beanz/typhon-scad/readme.md

# Typhon-scad
Cerberus-revised for MGN rails

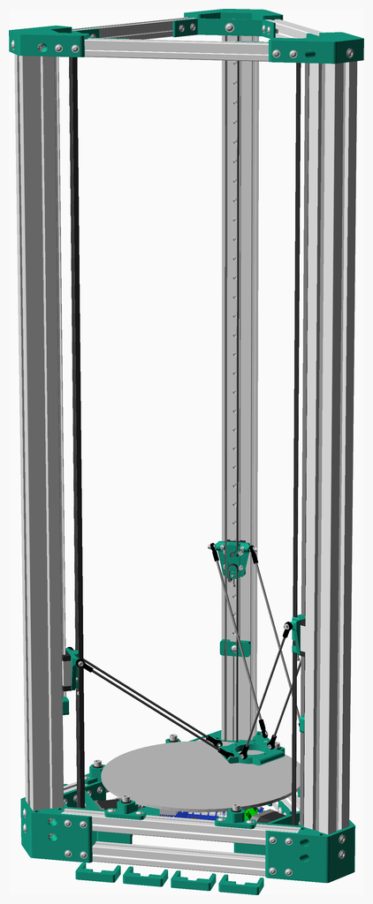
[picture p1: assemblies/main_assembled.png]
Main Assembly


<span></span>

---
## Table of Contents
1. [Parts list](#Parts_list)
1. [Duet Assembly](#duet_assembly)
1. [Effector Assembly](#effector_assembly)
1. [Idler Bearing Assembly](#idler_bearing_assembly)
1. [Idler Assembly](#idler_assembly)
1. [Top Corner Assembly](#top_corner_assembly)
1. [Bottom Motor Mount Assembly](#bottom_motor_mount_assembly)
1. [Bed Mount Right Assembly](#bed_mount_right_assembly)
1. [Bed Mount Left Assembly](#bed_mount_left_assembly)
1. [Bottom Extrusion Assembly](#bottom_extrusion_assembly)
1. [Bottom Corner Bottom Assembly](#bottom_corner_bottom_assembly)
1. [Two Part Bottom Corner Assembly](#two_part_bottom_corner_assembly)
1. [Bottom Corner Assembly](#bottom_corner_assembly)
1. [Arm Assembly](#arm_assembly)
1. [Carriage Assembly](#carriage_assembly)
1. [Rail Guard Assembly](#rail_guard_assembly)
1. [Upright C Assembly](#upright_c_assembly)
1. [Tower C Assembly](#tower_c_assembly)
1. [Upright B Assembly](#upright_b_assembly)
1. [Tower B Assembly](#tower_b_assembly)
1. [Upright A Assembly](#upright_a_assembly)
1. [Tower A Assembly](#tower_a_assembly)
1. [Main Assembly](#main_assembly)

<span></span>
[Top](#TOP)

---

## Parts list
| <span style="writing-mode: vertical-rl; text-orientation: mixed;">Duet</span> | <span style="writing-mode: vertical-rl; text-orientation: mixed;">Effector</span> | <span style="writing-mode: vertical-rl; text-orientation: mixed;">3 x Idler&nbsp;Bearing</span> | <span style="writing-mode: vertical-rl; text-orientation: mixed;">3 x Idler</span> | <span style="writing-mode: vertical-rl; text-orientation: mixed;">3 x Top&nbsp;Corner</span> | <span style="writing-mode: vertical-rl; text-orientation: mixed;">3 x Bottom&nbsp;Motor&nbsp;Mount</span> | <span style="writing-mode: vertical-rl; text-orientation: mixed;">3 x Bed&nbsp;Mount&nbsp;Right</span> | <span style="writing-mode: vertical-rl; text-orientation: mixed;">3 x Bed&nbsp;Mount&nbsp;Left</span> | <span style="writing-mode: vertical-rl; text-orientation: mixed;">3 x Bottom&nbsp;Extrusion</span> | <span style="writing-mode: vertical-rl; text-orientation: mixed;">3 x Bottom&nbsp;Corner&nbsp;Bottom</span> | <span style="writing-mode: vertical-rl; text-orientation: mixed;">3 x Two&nbsp;Part&nbsp;Bottom&nbsp;Corner</span> | <span style="writing-mode: vertical-rl; text-orientation: mixed;">3 x Bottom&nbsp;Corner</span> | <span style="writing-mode: vertical-rl; text-orientation: mixed;">3 x Arm</span> | <span style="writing-mode: vertical-rl; text-orientation: mixed;">3 x Carriage</span> | <span style="writing-mode: vertical-rl; text-orientation: mixed;">3 x Rail&nbsp;Guard</span> | <span style="writing-mode: vertical-rl; text-orientation: mixed;">Upright&nbsp;C</span> | <span style="writing-mode: vertical-rl; text-orientation: mixed;">Tower&nbsp;C</span> | <span style="writing-mode: vertical-rl; text-orientation: mixed;">Upright&nbsp;B</span> | <span style="writing-mode: vertical-rl; text-orientation: mixed;">Tower&nbsp;B</span> | <span style="writing-mode: vertical-rl; text-orientation: mixed;">Upright&nbsp;A</span> | <span style="writing-mode: vertical-rl; text-orientation: mixed;">Tower&nbsp;A</span> | <span style="writing-mode: vertical-rl; text-orientation: mixed;">Main</span> | <span style="writing-mode: vertical-rl; text-orientation: mixed;">TOTALS</span> |  |
|---:|---:|---:|---:|---:|---:|---:|---:|---:|---:|---:|---:|---:|---:|---:|---:|---:|---:|---:|---:|---:|---:|---:|:---|
|  |  |  |  |  |  |  |  |  |  |  |  |  |  |  |  |  |  |  |  |  |  | | **Vitamins** |
| &nbsp;&nbsp;.&nbsp; | &nbsp;&nbsp;.&nbsp; | &nbsp;&nbsp;6&nbsp; | &nbsp;&nbsp;.&nbsp; | &nbsp;&nbsp;.&nbsp; | &nbsp;&nbsp;.&nbsp; | &nbsp;&nbsp;.&nbsp; | &nbsp;&nbsp;.&nbsp; | &nbsp;&nbsp;.&nbsp; | &nbsp;&nbsp;.&nbsp; | &nbsp;&nbsp;.&nbsp; | &nbsp;&nbsp;.&nbsp; | &nbsp;&nbsp;.&nbsp; | &nbsp;&nbsp;.&nbsp; | &nbsp;&nbsp;.&nbsp; | &nbsp;&nbsp;.&nbsp; | &nbsp;&nbsp;.&nbsp; | &nbsp;&nbsp;.&nbsp; | &nbsp;&nbsp;.&nbsp; | &nbsp;&nbsp;.&nbsp; | &nbsp;&nbsp;.&nbsp; | &nbsp;&nbsp;.&nbsp; |  &nbsp;&nbsp;6&nbsp; | &nbsp;&nbsp; Ball bearing F625ZZ 5mm x 16mm x 5mm |
| &nbsp;&nbsp;.&nbsp; | &nbsp;&nbsp;.&nbsp; | &nbsp;&nbsp;.&nbsp; | &nbsp;&nbsp;.&nbsp; | &nbsp;&nbsp;.&nbsp; | &nbsp;&nbsp;.&nbsp; | &nbsp;&nbsp;.&nbsp; | &nbsp;&nbsp;.&nbsp; | &nbsp;&nbsp;.&nbsp; | &nbsp;&nbsp;.&nbsp; | &nbsp;&nbsp;.&nbsp; | &nbsp;&nbsp;.&nbsp; | &nbsp;&nbsp;.&nbsp; | &nbsp;&nbsp;.&nbsp; | &nbsp;&nbsp;.&nbsp; | &nbsp;&nbsp;.&nbsp; | &nbsp;&nbsp;1&nbsp; | &nbsp;&nbsp;.&nbsp; | &nbsp;&nbsp;.&nbsp; | &nbsp;&nbsp;.&nbsp; | &nbsp;&nbsp;.&nbsp; | &nbsp;&nbsp;.&nbsp; |  &nbsp;&nbsp;1&nbsp; | &nbsp;&nbsp; Belt GT2 x 6mm x 2072mm |
| &nbsp;&nbsp;.&nbsp; | &nbsp;&nbsp;.&nbsp; | &nbsp;&nbsp;.&nbsp; | &nbsp;&nbsp;.&nbsp; | &nbsp;&nbsp;.&nbsp; | &nbsp;&nbsp;.&nbsp; | &nbsp;&nbsp;.&nbsp; | &nbsp;&nbsp;.&nbsp; | &nbsp;&nbsp;.&nbsp; | &nbsp;&nbsp;.&nbsp; | &nbsp;&nbsp;.&nbsp; | &nbsp;&nbsp;.&nbsp; | &nbsp;&nbsp;.&nbsp; | &nbsp;&nbsp;.&nbsp; | &nbsp;&nbsp;.&nbsp; | &nbsp;&nbsp;.&nbsp; | &nbsp;&nbsp;.&nbsp; | &nbsp;&nbsp;.&nbsp; | &nbsp;&nbsp;1&nbsp; | &nbsp;&nbsp;.&nbsp; | &nbsp;&nbsp;.&nbsp; | &nbsp;&nbsp;.&nbsp; |  &nbsp;&nbsp;1&nbsp; | &nbsp;&nbsp; Belt GT2 x 6mm x 2072mm |
| &nbsp;&nbsp;.&nbsp; | &nbsp;&nbsp;.&nbsp; | &nbsp;&nbsp;.&nbsp; | &nbsp;&nbsp;.&nbsp; | &nbsp;&nbsp;.&nbsp; | &nbsp;&nbsp;.&nbsp; | &nbsp;&nbsp;.&nbsp; | &nbsp;&nbsp;.&nbsp; | &nbsp;&nbsp;.&nbsp; | &nbsp;&nbsp;.&nbsp; | &nbsp;&nbsp;.&nbsp; | &nbsp;&nbsp;.&nbsp; | &nbsp;&nbsp;.&nbsp; | &nbsp;&nbsp;.&nbsp; | &nbsp;&nbsp;.&nbsp; | &nbsp;&nbsp;.&nbsp; | &nbsp;&nbsp;.&nbsp; | &nbsp;&nbsp;.&nbsp; | &nbsp;&nbsp;.&nbsp; | &nbsp;&nbsp;.&nbsp; | &nbsp;&nbsp;1&nbsp; | &nbsp;&nbsp;.&nbsp; |  &nbsp;&nbsp;1&nbsp; | &nbsp;&nbsp; Belt GT2 x 6mm x 2072mm |
| &nbsp;&nbsp;.&nbsp; | &nbsp;&nbsp;.&nbsp; | &nbsp;&nbsp;.&nbsp; | &nbsp;&nbsp;.&nbsp; | &nbsp;&nbsp;.&nbsp; | &nbsp;&nbsp;.&nbsp; | &nbsp;&nbsp;.&nbsp; | &nbsp;&nbsp;.&nbsp; | &nbsp;&nbsp;.&nbsp; | &nbsp;&nbsp;.&nbsp; | &nbsp;&nbsp;.&nbsp; | &nbsp;&nbsp;.&nbsp; | &nbsp;&nbsp;6&nbsp; | &nbsp;&nbsp;.&nbsp; | &nbsp;&nbsp;.&nbsp; | &nbsp;&nbsp;.&nbsp; | &nbsp;&nbsp;.&nbsp; | &nbsp;&nbsp;.&nbsp; | &nbsp;&nbsp;.&nbsp; | &nbsp;&nbsp;.&nbsp; | &nbsp;&nbsp;.&nbsp; | &nbsp;&nbsp;.&nbsp; |  &nbsp;&nbsp;6&nbsp; | &nbsp;&nbsp; CF rod 3mm x 231mm |
| &nbsp;&nbsp;1&nbsp; | &nbsp;&nbsp;.&nbsp; | &nbsp;&nbsp;.&nbsp; | &nbsp;&nbsp;.&nbsp; | &nbsp;&nbsp;.&nbsp; | &nbsp;&nbsp;.&nbsp; | &nbsp;&nbsp;.&nbsp; | &nbsp;&nbsp;.&nbsp; | &nbsp;&nbsp;.&nbsp; | &nbsp;&nbsp;.&nbsp; | &nbsp;&nbsp;.&nbsp; | &nbsp;&nbsp;.&nbsp; | &nbsp;&nbsp;.&nbsp; | &nbsp;&nbsp;.&nbsp; | &nbsp;&nbsp;.&nbsp; | &nbsp;&nbsp;.&nbsp; | &nbsp;&nbsp;.&nbsp; | &nbsp;&nbsp;.&nbsp; | &nbsp;&nbsp;.&nbsp; | &nbsp;&nbsp;.&nbsp; | &nbsp;&nbsp;.&nbsp; | &nbsp;&nbsp;.&nbsp; |  &nbsp;&nbsp;1&nbsp; | &nbsp;&nbsp; Cat 5 patch cable 300mm |
| &nbsp;&nbsp;1&nbsp; | &nbsp;&nbsp;.&nbsp; | &nbsp;&nbsp;.&nbsp; | &nbsp;&nbsp;.&nbsp; | &nbsp;&nbsp;.&nbsp; | &nbsp;&nbsp;.&nbsp; | &nbsp;&nbsp;.&nbsp; | &nbsp;&nbsp;.&nbsp; | &nbsp;&nbsp;.&nbsp; | &nbsp;&nbsp;.&nbsp; | &nbsp;&nbsp;.&nbsp; | &nbsp;&nbsp;.&nbsp; | &nbsp;&nbsp;.&nbsp; | &nbsp;&nbsp;.&nbsp; | &nbsp;&nbsp;.&nbsp; | &nbsp;&nbsp;.&nbsp; | &nbsp;&nbsp;.&nbsp; | &nbsp;&nbsp;.&nbsp; | &nbsp;&nbsp;.&nbsp; | &nbsp;&nbsp;.&nbsp; | &nbsp;&nbsp;.&nbsp; | &nbsp;&nbsp;.&nbsp; |  &nbsp;&nbsp;1&nbsp; | &nbsp;&nbsp; Duet 2 Ethernet electronics |
| &nbsp;&nbsp;.&nbsp; | &nbsp;&nbsp;.&nbsp; | &nbsp;&nbsp;.&nbsp; | &nbsp;&nbsp;.&nbsp; | &nbsp;&nbsp;3&nbsp; | &nbsp;&nbsp;.&nbsp; | &nbsp;&nbsp;.&nbsp; | &nbsp;&nbsp;.&nbsp; | &nbsp;&nbsp;3&nbsp; | &nbsp;&nbsp;.&nbsp; | &nbsp;&nbsp;.&nbsp; | &nbsp;&nbsp;3&nbsp; | &nbsp;&nbsp;.&nbsp; | &nbsp;&nbsp;.&nbsp; | &nbsp;&nbsp;.&nbsp; | &nbsp;&nbsp;.&nbsp; | &nbsp;&nbsp;.&nbsp; | &nbsp;&nbsp;.&nbsp; | &nbsp;&nbsp;.&nbsp; | &nbsp;&nbsp;.&nbsp; | &nbsp;&nbsp;.&nbsp; | &nbsp;&nbsp;.&nbsp; |  &nbsp;&nbsp;9&nbsp; | &nbsp;&nbsp; Extrusion E2020 x 300mm |
| &nbsp;&nbsp;.&nbsp; | &nbsp;&nbsp;.&nbsp; | &nbsp;&nbsp;.&nbsp; | &nbsp;&nbsp;.&nbsp; | &nbsp;&nbsp;.&nbsp; | &nbsp;&nbsp;.&nbsp; | &nbsp;&nbsp;.&nbsp; | &nbsp;&nbsp;.&nbsp; | &nbsp;&nbsp;.&nbsp; | &nbsp;&nbsp;.&nbsp; | &nbsp;&nbsp;.&nbsp; | &nbsp;&nbsp;.&nbsp; | &nbsp;&nbsp;.&nbsp; | &nbsp;&nbsp;.&nbsp; | &nbsp;&nbsp;.&nbsp; | &nbsp;&nbsp;1&nbsp; | &nbsp;&nbsp;.&nbsp; | &nbsp;&nbsp;1&nbsp; | &nbsp;&nbsp;.&nbsp; | &nbsp;&nbsp;1&nbsp; | &nbsp;&nbsp;.&nbsp; | &nbsp;&nbsp;.&nbsp; |  &nbsp;&nbsp;3&nbsp; | &nbsp;&nbsp; Extrusion E4040 x 1000mm |
| &nbsp;&nbsp;.&nbsp; | &nbsp;&nbsp;.&nbsp; | &nbsp;&nbsp;.&nbsp; | &nbsp;&nbsp;.&nbsp; | &nbsp;&nbsp;.&nbsp; | &nbsp;&nbsp;.&nbsp; | &nbsp;&nbsp;.&nbsp; | &nbsp;&nbsp;.&nbsp; | &nbsp;&nbsp;.&nbsp; | &nbsp;&nbsp;24&nbsp; | &nbsp;&nbsp;.&nbsp; | &nbsp;&nbsp;.&nbsp; | &nbsp;&nbsp;.&nbsp; | &nbsp;&nbsp;.&nbsp; | &nbsp;&nbsp;.&nbsp; | &nbsp;&nbsp;.&nbsp; | &nbsp;&nbsp;.&nbsp; | &nbsp;&nbsp;.&nbsp; | &nbsp;&nbsp;.&nbsp; | &nbsp;&nbsp;.&nbsp; | &nbsp;&nbsp;.&nbsp; | &nbsp;&nbsp;.&nbsp; |  &nbsp;&nbsp;24&nbsp; | &nbsp;&nbsp; Heatfit insert M3 x 4mm |
| &nbsp;&nbsp;.&nbsp; | &nbsp;&nbsp;.&nbsp; | &nbsp;&nbsp;.&nbsp; | &nbsp;&nbsp;.&nbsp; | &nbsp;&nbsp;.&nbsp; | &nbsp;&nbsp;.&nbsp; | &nbsp;&nbsp;.&nbsp; | &nbsp;&nbsp;.&nbsp; | &nbsp;&nbsp;.&nbsp; | &nbsp;&nbsp;.&nbsp; | &nbsp;&nbsp;.&nbsp; | &nbsp;&nbsp;.&nbsp; | &nbsp;&nbsp;.&nbsp; | &nbsp;&nbsp;.&nbsp; | &nbsp;&nbsp;.&nbsp; | &nbsp;&nbsp;1&nbsp; | &nbsp;&nbsp;.&nbsp; | &nbsp;&nbsp;1&nbsp; | &nbsp;&nbsp;.&nbsp; | &nbsp;&nbsp;1&nbsp; | &nbsp;&nbsp;.&nbsp; | &nbsp;&nbsp;.&nbsp; |  &nbsp;&nbsp;3&nbsp; | &nbsp;&nbsp; Linear rail MGN12 x 800mm |
| &nbsp;&nbsp;.&nbsp; | &nbsp;&nbsp;.&nbsp; | &nbsp;&nbsp;.&nbsp; | &nbsp;&nbsp;.&nbsp; | &nbsp;&nbsp;.&nbsp; | &nbsp;&nbsp;.&nbsp; | &nbsp;&nbsp;.&nbsp; | &nbsp;&nbsp;.&nbsp; | &nbsp;&nbsp;.&nbsp; | &nbsp;&nbsp;.&nbsp; | &nbsp;&nbsp;.&nbsp; | &nbsp;&nbsp;.&nbsp; | &nbsp;&nbsp;.&nbsp; | &nbsp;&nbsp;3&nbsp; | &nbsp;&nbsp;.&nbsp; | &nbsp;&nbsp;.&nbsp; | &nbsp;&nbsp;.&nbsp; | &nbsp;&nbsp;.&nbsp; | &nbsp;&nbsp;.&nbsp; | &nbsp;&nbsp;.&nbsp; | &nbsp;&nbsp;.&nbsp; | &nbsp;&nbsp;.&nbsp; |  &nbsp;&nbsp;3&nbsp; | &nbsp;&nbsp; Linear rail carriage MGN12H |
| &nbsp;&nbsp;1&nbsp; | &nbsp;&nbsp;.&nbsp; | &nbsp;&nbsp;.&nbsp; | &nbsp;&nbsp;.&nbsp; | &nbsp;&nbsp;.&nbsp; | &nbsp;&nbsp;.&nbsp; | &nbsp;&nbsp;.&nbsp; | &nbsp;&nbsp;.&nbsp; | &nbsp;&nbsp;.&nbsp; | &nbsp;&nbsp;.&nbsp; | &nbsp;&nbsp;.&nbsp; | &nbsp;&nbsp;.&nbsp; | &nbsp;&nbsp;.&nbsp; | &nbsp;&nbsp;.&nbsp; | &nbsp;&nbsp;.&nbsp; | &nbsp;&nbsp;.&nbsp; | &nbsp;&nbsp;.&nbsp; | &nbsp;&nbsp;.&nbsp; | &nbsp;&nbsp;.&nbsp; | &nbsp;&nbsp;.&nbsp; | &nbsp;&nbsp;.&nbsp; | &nbsp;&nbsp;.&nbsp; |  &nbsp;&nbsp;1&nbsp; | &nbsp;&nbsp; Micro SD card |
| &nbsp;&nbsp;.&nbsp; | &nbsp;&nbsp;.&nbsp; | &nbsp;&nbsp;.&nbsp; | &nbsp;&nbsp;.&nbsp; | &nbsp;&nbsp;.&nbsp; | &nbsp;&nbsp;.&nbsp; | &nbsp;&nbsp;.&nbsp; | &nbsp;&nbsp;.&nbsp; | &nbsp;&nbsp;.&nbsp; | &nbsp;&nbsp;.&nbsp; | &nbsp;&nbsp;.&nbsp; | &nbsp;&nbsp;.&nbsp; | &nbsp;&nbsp;.&nbsp; | &nbsp;&nbsp;3&nbsp; | &nbsp;&nbsp;.&nbsp; | &nbsp;&nbsp;.&nbsp; | &nbsp;&nbsp;.&nbsp; | &nbsp;&nbsp;.&nbsp; | &nbsp;&nbsp;.&nbsp; | &nbsp;&nbsp;.&nbsp; | &nbsp;&nbsp;.&nbsp; | &nbsp;&nbsp;.&nbsp; |  &nbsp;&nbsp;3&nbsp; | &nbsp;&nbsp; Nut M3 x 2.4mm  |
| &nbsp;&nbsp;.&nbsp; | &nbsp;&nbsp;.&nbsp; | &nbsp;&nbsp;.&nbsp; | &nbsp;&nbsp;.&nbsp; | &nbsp;&nbsp;.&nbsp; | &nbsp;&nbsp;.&nbsp; | &nbsp;&nbsp;.&nbsp; | &nbsp;&nbsp;.&nbsp; | &nbsp;&nbsp;.&nbsp; | &nbsp;&nbsp;.&nbsp; | &nbsp;&nbsp;.&nbsp; | &nbsp;&nbsp;.&nbsp; | &nbsp;&nbsp;.&nbsp; | &nbsp;&nbsp;6&nbsp; | &nbsp;&nbsp;.&nbsp; | &nbsp;&nbsp;.&nbsp; | &nbsp;&nbsp;.&nbsp; | &nbsp;&nbsp;.&nbsp; | &nbsp;&nbsp;.&nbsp; | &nbsp;&nbsp;.&nbsp; | &nbsp;&nbsp;.&nbsp; | &nbsp;&nbsp;.&nbsp; |  &nbsp;&nbsp;6&nbsp; | &nbsp;&nbsp; Nut M3 x 2.4mm nyloc |
| &nbsp;&nbsp;.&nbsp; | &nbsp;&nbsp;.&nbsp; | &nbsp;&nbsp;.&nbsp; | &nbsp;&nbsp;12&nbsp; | &nbsp;&nbsp;24&nbsp; | &nbsp;&nbsp;24&nbsp; | &nbsp;&nbsp;6&nbsp; | &nbsp;&nbsp;6&nbsp; | &nbsp;&nbsp;.&nbsp; | &nbsp;&nbsp;.&nbsp; | &nbsp;&nbsp;.&nbsp; | &nbsp;&nbsp;48&nbsp; | &nbsp;&nbsp;.&nbsp; | &nbsp;&nbsp;.&nbsp; | &nbsp;&nbsp;.&nbsp; | &nbsp;&nbsp;.&nbsp; | &nbsp;&nbsp;.&nbsp; | &nbsp;&nbsp;.&nbsp; | &nbsp;&nbsp;.&nbsp; | &nbsp;&nbsp;.&nbsp; | &nbsp;&nbsp;.&nbsp; | &nbsp;&nbsp;.&nbsp; |  &nbsp;&nbsp;120&nbsp; | &nbsp;&nbsp; Nut M4 sliding T |
| &nbsp;&nbsp;4&nbsp; | &nbsp;&nbsp;.&nbsp; | &nbsp;&nbsp;.&nbsp; | &nbsp;&nbsp;3&nbsp; | &nbsp;&nbsp;9&nbsp; | &nbsp;&nbsp;.&nbsp; | &nbsp;&nbsp;.&nbsp; | &nbsp;&nbsp;.&nbsp; | &nbsp;&nbsp;.&nbsp; | &nbsp;&nbsp;.&nbsp; | &nbsp;&nbsp;.&nbsp; | &nbsp;&nbsp;18&nbsp; | &nbsp;&nbsp;.&nbsp; | &nbsp;&nbsp;.&nbsp; | &nbsp;&nbsp;3&nbsp; | &nbsp;&nbsp;.&nbsp; | &nbsp;&nbsp;.&nbsp; | &nbsp;&nbsp;.&nbsp; | &nbsp;&nbsp;.&nbsp; | &nbsp;&nbsp;.&nbsp; | &nbsp;&nbsp;.&nbsp; | &nbsp;&nbsp;.&nbsp; |  &nbsp;&nbsp;37&nbsp; | &nbsp;&nbsp; Nut M5 sliding T |
| &nbsp;&nbsp;.&nbsp; | &nbsp;&nbsp;.&nbsp; | &nbsp;&nbsp;.&nbsp; | &nbsp;&nbsp;.&nbsp; | &nbsp;&nbsp;.&nbsp; | &nbsp;&nbsp;3&nbsp; | &nbsp;&nbsp;.&nbsp; | &nbsp;&nbsp;.&nbsp; | &nbsp;&nbsp;.&nbsp; | &nbsp;&nbsp;.&nbsp; | &nbsp;&nbsp;.&nbsp; | &nbsp;&nbsp;.&nbsp; | &nbsp;&nbsp;.&nbsp; | &nbsp;&nbsp;.&nbsp; | &nbsp;&nbsp;.&nbsp; | &nbsp;&nbsp;.&nbsp; | &nbsp;&nbsp;.&nbsp; | &nbsp;&nbsp;.&nbsp; | &nbsp;&nbsp;.&nbsp; | &nbsp;&nbsp;.&nbsp; | &nbsp;&nbsp;.&nbsp; | &nbsp;&nbsp;.&nbsp; |  &nbsp;&nbsp;3&nbsp; | &nbsp;&nbsp; Pulley GT2OB 20 teeth |
| &nbsp;&nbsp;4&nbsp; | &nbsp;&nbsp;.&nbsp; | &nbsp;&nbsp;.&nbsp; | &nbsp;&nbsp;.&nbsp; | &nbsp;&nbsp;.&nbsp; | &nbsp;&nbsp;.&nbsp; | &nbsp;&nbsp;.&nbsp; | &nbsp;&nbsp;.&nbsp; | &nbsp;&nbsp;.&nbsp; | &nbsp;&nbsp;.&nbsp; | &nbsp;&nbsp;.&nbsp; | &nbsp;&nbsp;.&nbsp; | &nbsp;&nbsp;.&nbsp; | &nbsp;&nbsp;.&nbsp; | &nbsp;&nbsp;.&nbsp; | &nbsp;&nbsp;.&nbsp; | &nbsp;&nbsp;.&nbsp; | &nbsp;&nbsp;.&nbsp; | &nbsp;&nbsp;.&nbsp; | &nbsp;&nbsp;.&nbsp; | &nbsp;&nbsp;.&nbsp; | &nbsp;&nbsp;.&nbsp; |  &nbsp;&nbsp;4&nbsp; | &nbsp;&nbsp; Screw M3 cap x  6mm |
| &nbsp;&nbsp;.&nbsp; | &nbsp;&nbsp;.&nbsp; | &nbsp;&nbsp;.&nbsp; | &nbsp;&nbsp;.&nbsp; | &nbsp;&nbsp;.&nbsp; | &nbsp;&nbsp;12&nbsp; | &nbsp;&nbsp;.&nbsp; | &nbsp;&nbsp;.&nbsp; | &nbsp;&nbsp;.&nbsp; | &nbsp;&nbsp;.&nbsp; | &nbsp;&nbsp;.&nbsp; | &nbsp;&nbsp;.&nbsp; | &nbsp;&nbsp;.&nbsp; | &nbsp;&nbsp;.&nbsp; | &nbsp;&nbsp;.&nbsp; | &nbsp;&nbsp;.&nbsp; | &nbsp;&nbsp;.&nbsp; | &nbsp;&nbsp;.&nbsp; | &nbsp;&nbsp;.&nbsp; | &nbsp;&nbsp;.&nbsp; | &nbsp;&nbsp;.&nbsp; | &nbsp;&nbsp;.&nbsp; |  &nbsp;&nbsp;12&nbsp; | &nbsp;&nbsp; Screw M3 cap x  8mm |
| &nbsp;&nbsp;.&nbsp; | &nbsp;&nbsp;.&nbsp; | &nbsp;&nbsp;.&nbsp; | &nbsp;&nbsp;.&nbsp; | &nbsp;&nbsp;.&nbsp; | &nbsp;&nbsp;.&nbsp; | &nbsp;&nbsp;.&nbsp; | &nbsp;&nbsp;.&nbsp; | &nbsp;&nbsp;.&nbsp; | &nbsp;&nbsp;.&nbsp; | &nbsp;&nbsp;24&nbsp; | &nbsp;&nbsp;.&nbsp; | &nbsp;&nbsp;.&nbsp; | &nbsp;&nbsp;12&nbsp; | &nbsp;&nbsp;.&nbsp; | &nbsp;&nbsp;.&nbsp; | &nbsp;&nbsp;.&nbsp; | &nbsp;&nbsp;.&nbsp; | &nbsp;&nbsp;.&nbsp; | &nbsp;&nbsp;.&nbsp; | &nbsp;&nbsp;.&nbsp; | &nbsp;&nbsp;.&nbsp; |  &nbsp;&nbsp;36&nbsp; | &nbsp;&nbsp; Screw M3 cap x 10mm |
| &nbsp;&nbsp;.&nbsp; | &nbsp;&nbsp;.&nbsp; | &nbsp;&nbsp;.&nbsp; | &nbsp;&nbsp;.&nbsp; | &nbsp;&nbsp;.&nbsp; | &nbsp;&nbsp;.&nbsp; | &nbsp;&nbsp;.&nbsp; | &nbsp;&nbsp;.&nbsp; | &nbsp;&nbsp;.&nbsp; | &nbsp;&nbsp;.&nbsp; | &nbsp;&nbsp;.&nbsp; | &nbsp;&nbsp;.&nbsp; | &nbsp;&nbsp;.&nbsp; | &nbsp;&nbsp;.&nbsp; | &nbsp;&nbsp;.&nbsp; | &nbsp;&nbsp;18&nbsp; | &nbsp;&nbsp;.&nbsp; | &nbsp;&nbsp;18&nbsp; | &nbsp;&nbsp;.&nbsp; | &nbsp;&nbsp;18&nbsp; | &nbsp;&nbsp;.&nbsp; | &nbsp;&nbsp;.&nbsp; |  &nbsp;&nbsp;54&nbsp; | &nbsp;&nbsp; Screw M3 cap x 16mm |
| &nbsp;&nbsp;.&nbsp; | &nbsp;&nbsp;.&nbsp; | &nbsp;&nbsp;.&nbsp; | &nbsp;&nbsp;.&nbsp; | &nbsp;&nbsp;.&nbsp; | &nbsp;&nbsp;.&nbsp; | &nbsp;&nbsp;.&nbsp; | &nbsp;&nbsp;.&nbsp; | &nbsp;&nbsp;.&nbsp; | &nbsp;&nbsp;.&nbsp; | &nbsp;&nbsp;.&nbsp; | &nbsp;&nbsp;.&nbsp; | &nbsp;&nbsp;.&nbsp; | &nbsp;&nbsp;9&nbsp; | &nbsp;&nbsp;.&nbsp; | &nbsp;&nbsp;.&nbsp; | &nbsp;&nbsp;.&nbsp; | &nbsp;&nbsp;.&nbsp; | &nbsp;&nbsp;.&nbsp; | &nbsp;&nbsp;.&nbsp; | &nbsp;&nbsp;.&nbsp; | &nbsp;&nbsp;.&nbsp; |  &nbsp;&nbsp;9&nbsp; | &nbsp;&nbsp; Screw M3 cap x 20mm |
| &nbsp;&nbsp;.&nbsp; | &nbsp;&nbsp;.&nbsp; | &nbsp;&nbsp;.&nbsp; | &nbsp;&nbsp;.&nbsp; | &nbsp;&nbsp;.&nbsp; | &nbsp;&nbsp;6&nbsp; | &nbsp;&nbsp;.&nbsp; | &nbsp;&nbsp;.&nbsp; | &nbsp;&nbsp;.&nbsp; | &nbsp;&nbsp;.&nbsp; | &nbsp;&nbsp;.&nbsp; | &nbsp;&nbsp;.&nbsp; | &nbsp;&nbsp;.&nbsp; | &nbsp;&nbsp;.&nbsp; | &nbsp;&nbsp;.&nbsp; | &nbsp;&nbsp;.&nbsp; | &nbsp;&nbsp;.&nbsp; | &nbsp;&nbsp;.&nbsp; | &nbsp;&nbsp;.&nbsp; | &nbsp;&nbsp;.&nbsp; | &nbsp;&nbsp;.&nbsp; | &nbsp;&nbsp;.&nbsp; |  &nbsp;&nbsp;6&nbsp; | &nbsp;&nbsp; Screw M3 grub x  6mm |
| &nbsp;&nbsp;.&nbsp; | &nbsp;&nbsp;.&nbsp; | &nbsp;&nbsp;.&nbsp; | &nbsp;&nbsp;12&nbsp; | &nbsp;&nbsp;24&nbsp; | &nbsp;&nbsp;24&nbsp; | &nbsp;&nbsp;6&nbsp; | &nbsp;&nbsp;6&nbsp; | &nbsp;&nbsp;.&nbsp; | &nbsp;&nbsp;.&nbsp; | &nbsp;&nbsp;.&nbsp; | &nbsp;&nbsp;48&nbsp; | &nbsp;&nbsp;.&nbsp; | &nbsp;&nbsp;.&nbsp; | &nbsp;&nbsp;.&nbsp; | &nbsp;&nbsp;.&nbsp; | &nbsp;&nbsp;.&nbsp; | &nbsp;&nbsp;.&nbsp; | &nbsp;&nbsp;.&nbsp; | &nbsp;&nbsp;.&nbsp; | &nbsp;&nbsp;.&nbsp; | &nbsp;&nbsp;.&nbsp; |  &nbsp;&nbsp;120&nbsp; | &nbsp;&nbsp; Screw M4 flanged x 10mm |
| &nbsp;&nbsp;4&nbsp; | &nbsp;&nbsp;.&nbsp; | &nbsp;&nbsp;.&nbsp; | &nbsp;&nbsp;.&nbsp; | &nbsp;&nbsp;9&nbsp; | &nbsp;&nbsp;.&nbsp; | &nbsp;&nbsp;.&nbsp; | &nbsp;&nbsp;.&nbsp; | &nbsp;&nbsp;.&nbsp; | &nbsp;&nbsp;.&nbsp; | &nbsp;&nbsp;.&nbsp; | &nbsp;&nbsp;18&nbsp; | &nbsp;&nbsp;.&nbsp; | &nbsp;&nbsp;.&nbsp; | &nbsp;&nbsp;3&nbsp; | &nbsp;&nbsp;.&nbsp; | &nbsp;&nbsp;.&nbsp; | &nbsp;&nbsp;.&nbsp; | &nbsp;&nbsp;.&nbsp; | &nbsp;&nbsp;.&nbsp; | &nbsp;&nbsp;.&nbsp; | &nbsp;&nbsp;.&nbsp; |  &nbsp;&nbsp;34&nbsp; | &nbsp;&nbsp; Screw M5 flanged x 16mm |
| &nbsp;&nbsp;.&nbsp; | &nbsp;&nbsp;.&nbsp; | &nbsp;&nbsp;.&nbsp; | &nbsp;&nbsp;3&nbsp; | &nbsp;&nbsp;.&nbsp; | &nbsp;&nbsp;.&nbsp; | &nbsp;&nbsp;.&nbsp; | &nbsp;&nbsp;.&nbsp; | &nbsp;&nbsp;.&nbsp; | &nbsp;&nbsp;.&nbsp; | &nbsp;&nbsp;.&nbsp; | &nbsp;&nbsp;.&nbsp; | &nbsp;&nbsp;.&nbsp; | &nbsp;&nbsp;.&nbsp; | &nbsp;&nbsp;.&nbsp; | &nbsp;&nbsp;.&nbsp; | &nbsp;&nbsp;.&nbsp; | &nbsp;&nbsp;.&nbsp; | &nbsp;&nbsp;.&nbsp; | &nbsp;&nbsp;.&nbsp; | &nbsp;&nbsp;.&nbsp; | &nbsp;&nbsp;.&nbsp; |  &nbsp;&nbsp;3&nbsp; | &nbsp;&nbsp; Screw M5 flanged x 49mm |
| &nbsp;&nbsp;.&nbsp; | &nbsp;&nbsp;.&nbsp; | &nbsp;&nbsp;.&nbsp; | &nbsp;&nbsp;.&nbsp; | &nbsp;&nbsp;.&nbsp; | &nbsp;&nbsp;.&nbsp; | &nbsp;&nbsp;3&nbsp; | &nbsp;&nbsp;3&nbsp; | &nbsp;&nbsp;.&nbsp; | &nbsp;&nbsp;.&nbsp; | &nbsp;&nbsp;.&nbsp; | &nbsp;&nbsp;.&nbsp; | &nbsp;&nbsp;.&nbsp; | &nbsp;&nbsp;.&nbsp; | &nbsp;&nbsp;.&nbsp; | &nbsp;&nbsp;.&nbsp; | &nbsp;&nbsp;.&nbsp; | &nbsp;&nbsp;.&nbsp; | &nbsp;&nbsp;.&nbsp; | &nbsp;&nbsp;.&nbsp; | &nbsp;&nbsp;.&nbsp; | &nbsp;&nbsp;.&nbsp; |  &nbsp;&nbsp;6&nbsp; | &nbsp;&nbsp; Screw M6 cap x 10mm |
| &nbsp;&nbsp;.&nbsp; | &nbsp;&nbsp;.&nbsp; | &nbsp;&nbsp;.&nbsp; | &nbsp;&nbsp;.&nbsp; | &nbsp;&nbsp;.&nbsp; | &nbsp;&nbsp;3&nbsp; | &nbsp;&nbsp;.&nbsp; | &nbsp;&nbsp;.&nbsp; | &nbsp;&nbsp;.&nbsp; | &nbsp;&nbsp;.&nbsp; | &nbsp;&nbsp;.&nbsp; | &nbsp;&nbsp;.&nbsp; | &nbsp;&nbsp;.&nbsp; | &nbsp;&nbsp;.&nbsp; | &nbsp;&nbsp;.&nbsp; | &nbsp;&nbsp;.&nbsp; | &nbsp;&nbsp;.&nbsp; | &nbsp;&nbsp;.&nbsp; | &nbsp;&nbsp;.&nbsp; | &nbsp;&nbsp;.&nbsp; | &nbsp;&nbsp;.&nbsp; | &nbsp;&nbsp;.&nbsp; |  &nbsp;&nbsp;3&nbsp; | &nbsp;&nbsp; Stepper motor NEMA17 x 47mm (5x24 shaft) |
| &nbsp;&nbsp;.&nbsp; | &nbsp;&nbsp;.&nbsp; | &nbsp;&nbsp;.&nbsp; | &nbsp;&nbsp;.&nbsp; | &nbsp;&nbsp;.&nbsp; | &nbsp;&nbsp;12&nbsp; | &nbsp;&nbsp;.&nbsp; | &nbsp;&nbsp;.&nbsp; | &nbsp;&nbsp;.&nbsp; | &nbsp;&nbsp;.&nbsp; | &nbsp;&nbsp;.&nbsp; | &nbsp;&nbsp;.&nbsp; | &nbsp;&nbsp;.&nbsp; | &nbsp;&nbsp;24&nbsp; | &nbsp;&nbsp;.&nbsp; | &nbsp;&nbsp;.&nbsp; | &nbsp;&nbsp;.&nbsp; | &nbsp;&nbsp;.&nbsp; | &nbsp;&nbsp;.&nbsp; | &nbsp;&nbsp;.&nbsp; | &nbsp;&nbsp;.&nbsp; | &nbsp;&nbsp;.&nbsp; |  &nbsp;&nbsp;36&nbsp; | &nbsp;&nbsp; Washer  M3 x 7mm x 0.5mm |
| &nbsp;&nbsp;.&nbsp; | &nbsp;&nbsp;.&nbsp; | &nbsp;&nbsp;6&nbsp; | &nbsp;&nbsp;.&nbsp; | &nbsp;&nbsp;.&nbsp; | &nbsp;&nbsp;.&nbsp; | &nbsp;&nbsp;.&nbsp; | &nbsp;&nbsp;.&nbsp; | &nbsp;&nbsp;.&nbsp; | &nbsp;&nbsp;.&nbsp; | &nbsp;&nbsp;.&nbsp; | &nbsp;&nbsp;.&nbsp; | &nbsp;&nbsp;.&nbsp; | &nbsp;&nbsp;.&nbsp; | &nbsp;&nbsp;.&nbsp; | &nbsp;&nbsp;.&nbsp; | &nbsp;&nbsp;.&nbsp; | &nbsp;&nbsp;.&nbsp; | &nbsp;&nbsp;.&nbsp; | &nbsp;&nbsp;.&nbsp; | &nbsp;&nbsp;.&nbsp; | &nbsp;&nbsp;.&nbsp; |  &nbsp;&nbsp;6&nbsp; | &nbsp;&nbsp; Washer  M5 x 10mm x 1mm |
| &nbsp;&nbsp;.&nbsp; | &nbsp;&nbsp;.&nbsp; | &nbsp;&nbsp;.&nbsp; | &nbsp;&nbsp;.&nbsp; | &nbsp;&nbsp;.&nbsp; | &nbsp;&nbsp;.&nbsp; | &nbsp;&nbsp;3&nbsp; | &nbsp;&nbsp;3&nbsp; | &nbsp;&nbsp;.&nbsp; | &nbsp;&nbsp;.&nbsp; | &nbsp;&nbsp;.&nbsp; | &nbsp;&nbsp;.&nbsp; | &nbsp;&nbsp;.&nbsp; | &nbsp;&nbsp;.&nbsp; | &nbsp;&nbsp;.&nbsp; | &nbsp;&nbsp;.&nbsp; | &nbsp;&nbsp;.&nbsp; | &nbsp;&nbsp;.&nbsp; | &nbsp;&nbsp;.&nbsp; | &nbsp;&nbsp;.&nbsp; | &nbsp;&nbsp;.&nbsp; | &nbsp;&nbsp;.&nbsp; |  &nbsp;&nbsp;6&nbsp; | &nbsp;&nbsp; Washer rubber M6 x 12.5mm x 1.5mm |
| &nbsp;&nbsp;15&nbsp; | &nbsp;&nbsp;.&nbsp; | &nbsp;&nbsp;12&nbsp; | &nbsp;&nbsp;30&nbsp; | &nbsp;&nbsp;69&nbsp; | &nbsp;&nbsp;84&nbsp; | &nbsp;&nbsp;18&nbsp; | &nbsp;&nbsp;18&nbsp; | &nbsp;&nbsp;3&nbsp; | &nbsp;&nbsp;24&nbsp; | &nbsp;&nbsp;24&nbsp; | &nbsp;&nbsp;135&nbsp; | &nbsp;&nbsp;6&nbsp; | &nbsp;&nbsp;57&nbsp; | &nbsp;&nbsp;6&nbsp; | &nbsp;&nbsp;20&nbsp; | &nbsp;&nbsp;1&nbsp; | &nbsp;&nbsp;20&nbsp; | &nbsp;&nbsp;1&nbsp; | &nbsp;&nbsp;20&nbsp; | &nbsp;&nbsp;1&nbsp; | &nbsp;&nbsp;.&nbsp; | &nbsp;&nbsp;564&nbsp; | &nbsp;&nbsp;Total vitamins count |
|  |  |  |  |  |  |  |  |  |  |  |  |  |  |  |  |  |  |  |  |  |  | | **3D printed parts** |
| &nbsp;&nbsp;.&nbsp; | &nbsp;&nbsp;.&nbsp; | &nbsp;&nbsp;.&nbsp; | &nbsp;&nbsp;.&nbsp; | &nbsp;&nbsp;.&nbsp; | &nbsp;&nbsp;.&nbsp; | &nbsp;&nbsp;.&nbsp; | &nbsp;&nbsp;3&nbsp; | &nbsp;&nbsp;.&nbsp; | &nbsp;&nbsp;.&nbsp; | &nbsp;&nbsp;.&nbsp; | &nbsp;&nbsp;.&nbsp; | &nbsp;&nbsp;.&nbsp; | &nbsp;&nbsp;.&nbsp; | &nbsp;&nbsp;.&nbsp; | &nbsp;&nbsp;.&nbsp; | &nbsp;&nbsp;.&nbsp; | &nbsp;&nbsp;.&nbsp; | &nbsp;&nbsp;.&nbsp; | &nbsp;&nbsp;.&nbsp; | &nbsp;&nbsp;.&nbsp; | &nbsp;&nbsp;.&nbsp; |  &nbsp;&nbsp;3&nbsp; | &nbsp;&nbsp;bed_mount_left.stl |
| &nbsp;&nbsp;.&nbsp; | &nbsp;&nbsp;.&nbsp; | &nbsp;&nbsp;.&nbsp; | &nbsp;&nbsp;.&nbsp; | &nbsp;&nbsp;.&nbsp; | &nbsp;&nbsp;.&nbsp; | &nbsp;&nbsp;3&nbsp; | &nbsp;&nbsp;.&nbsp; | &nbsp;&nbsp;.&nbsp; | &nbsp;&nbsp;.&nbsp; | &nbsp;&nbsp;.&nbsp; | &nbsp;&nbsp;.&nbsp; | &nbsp;&nbsp;.&nbsp; | &nbsp;&nbsp;.&nbsp; | &nbsp;&nbsp;.&nbsp; | &nbsp;&nbsp;.&nbsp; | &nbsp;&nbsp;.&nbsp; | &nbsp;&nbsp;.&nbsp; | &nbsp;&nbsp;.&nbsp; | &nbsp;&nbsp;.&nbsp; | &nbsp;&nbsp;.&nbsp; | &nbsp;&nbsp;.&nbsp; |  &nbsp;&nbsp;3&nbsp; | &nbsp;&nbsp;bed_mount_right.stl |
| &nbsp;&nbsp;.&nbsp; | &nbsp;&nbsp;.&nbsp; | &nbsp;&nbsp;.&nbsp; | &nbsp;&nbsp;.&nbsp; | &nbsp;&nbsp;.&nbsp; | &nbsp;&nbsp;.&nbsp; | &nbsp;&nbsp;.&nbsp; | &nbsp;&nbsp;.&nbsp; | &nbsp;&nbsp;.&nbsp; | &nbsp;&nbsp;3&nbsp; | &nbsp;&nbsp;.&nbsp; | &nbsp;&nbsp;.&nbsp; | &nbsp;&nbsp;.&nbsp; | &nbsp;&nbsp;.&nbsp; | &nbsp;&nbsp;.&nbsp; | &nbsp;&nbsp;.&nbsp; | &nbsp;&nbsp;.&nbsp; | &nbsp;&nbsp;.&nbsp; | &nbsp;&nbsp;.&nbsp; | &nbsp;&nbsp;.&nbsp; | &nbsp;&nbsp;.&nbsp; | &nbsp;&nbsp;.&nbsp; |  &nbsp;&nbsp;3&nbsp; | &nbsp;&nbsp;bottom_corner_bottom.stl |
| &nbsp;&nbsp;.&nbsp; | &nbsp;&nbsp;.&nbsp; | &nbsp;&nbsp;.&nbsp; | &nbsp;&nbsp;.&nbsp; | &nbsp;&nbsp;.&nbsp; | &nbsp;&nbsp;.&nbsp; | &nbsp;&nbsp;.&nbsp; | &nbsp;&nbsp;.&nbsp; | &nbsp;&nbsp;.&nbsp; | &nbsp;&nbsp;.&nbsp; | &nbsp;&nbsp;3&nbsp; | &nbsp;&nbsp;.&nbsp; | &nbsp;&nbsp;.&nbsp; | &nbsp;&nbsp;.&nbsp; | &nbsp;&nbsp;.&nbsp; | &nbsp;&nbsp;.&nbsp; | &nbsp;&nbsp;.&nbsp; | &nbsp;&nbsp;.&nbsp; | &nbsp;&nbsp;.&nbsp; | &nbsp;&nbsp;.&nbsp; | &nbsp;&nbsp;.&nbsp; | &nbsp;&nbsp;.&nbsp; |  &nbsp;&nbsp;3&nbsp; | &nbsp;&nbsp;bottom_corner_top.stl |
| &nbsp;&nbsp;.&nbsp; | &nbsp;&nbsp;.&nbsp; | &nbsp;&nbsp;.&nbsp; | &nbsp;&nbsp;.&nbsp; | &nbsp;&nbsp;.&nbsp; | &nbsp;&nbsp;3&nbsp; | &nbsp;&nbsp;.&nbsp; | &nbsp;&nbsp;.&nbsp; | &nbsp;&nbsp;.&nbsp; | &nbsp;&nbsp;.&nbsp; | &nbsp;&nbsp;.&nbsp; | &nbsp;&nbsp;.&nbsp; | &nbsp;&nbsp;.&nbsp; | &nbsp;&nbsp;.&nbsp; | &nbsp;&nbsp;.&nbsp; | &nbsp;&nbsp;.&nbsp; | &nbsp;&nbsp;.&nbsp; | &nbsp;&nbsp;.&nbsp; | &nbsp;&nbsp;.&nbsp; | &nbsp;&nbsp;.&nbsp; | &nbsp;&nbsp;.&nbsp; | &nbsp;&nbsp;.&nbsp; |  &nbsp;&nbsp;3&nbsp; | &nbsp;&nbsp;bottom_motor_mount.stl |
| &nbsp;&nbsp;.&nbsp; | &nbsp;&nbsp;.&nbsp; | &nbsp;&nbsp;.&nbsp; | &nbsp;&nbsp;.&nbsp; | &nbsp;&nbsp;.&nbsp; | &nbsp;&nbsp;.&nbsp; | &nbsp;&nbsp;.&nbsp; | &nbsp;&nbsp;.&nbsp; | &nbsp;&nbsp;.&nbsp; | &nbsp;&nbsp;.&nbsp; | &nbsp;&nbsp;.&nbsp; | &nbsp;&nbsp;.&nbsp; | &nbsp;&nbsp;.&nbsp; | &nbsp;&nbsp;3&nbsp; | &nbsp;&nbsp;.&nbsp; | &nbsp;&nbsp;.&nbsp; | &nbsp;&nbsp;.&nbsp; | &nbsp;&nbsp;.&nbsp; | &nbsp;&nbsp;.&nbsp; | &nbsp;&nbsp;.&nbsp; | &nbsp;&nbsp;.&nbsp; | &nbsp;&nbsp;.&nbsp; |  &nbsp;&nbsp;3&nbsp; | &nbsp;&nbsp;carriage.stl |
| &nbsp;&nbsp;.&nbsp; | &nbsp;&nbsp;.&nbsp; | &nbsp;&nbsp;.&nbsp; | &nbsp;&nbsp;.&nbsp; | &nbsp;&nbsp;.&nbsp; | &nbsp;&nbsp;.&nbsp; | &nbsp;&nbsp;.&nbsp; | &nbsp;&nbsp;.&nbsp; | &nbsp;&nbsp;.&nbsp; | &nbsp;&nbsp;.&nbsp; | &nbsp;&nbsp;.&nbsp; | &nbsp;&nbsp;.&nbsp; | &nbsp;&nbsp;.&nbsp; | &nbsp;&nbsp;3&nbsp; | &nbsp;&nbsp;.&nbsp; | &nbsp;&nbsp;.&nbsp; | &nbsp;&nbsp;.&nbsp; | &nbsp;&nbsp;.&nbsp; | &nbsp;&nbsp;.&nbsp; | &nbsp;&nbsp;.&nbsp; | &nbsp;&nbsp;.&nbsp; | &nbsp;&nbsp;.&nbsp; |  &nbsp;&nbsp;3&nbsp; | &nbsp;&nbsp;carriage_belt_tensioner.stl |
| &nbsp;&nbsp;.&nbsp; | &nbsp;&nbsp;1&nbsp; | &nbsp;&nbsp;.&nbsp; | &nbsp;&nbsp;.&nbsp; | &nbsp;&nbsp;.&nbsp; | &nbsp;&nbsp;.&nbsp; | &nbsp;&nbsp;.&nbsp; | &nbsp;&nbsp;.&nbsp; | &nbsp;&nbsp;.&nbsp; | &nbsp;&nbsp;.&nbsp; | &nbsp;&nbsp;.&nbsp; | &nbsp;&nbsp;.&nbsp; | &nbsp;&nbsp;.&nbsp; | &nbsp;&nbsp;.&nbsp; | &nbsp;&nbsp;.&nbsp; | &nbsp;&nbsp;.&nbsp; | &nbsp;&nbsp;.&nbsp; | &nbsp;&nbsp;.&nbsp; | &nbsp;&nbsp;.&nbsp; | &nbsp;&nbsp;.&nbsp; | &nbsp;&nbsp;.&nbsp; | &nbsp;&nbsp;.&nbsp; |  &nbsp;&nbsp;1&nbsp; | &nbsp;&nbsp;effector.stl |
| &nbsp;&nbsp;.&nbsp; | &nbsp;&nbsp;.&nbsp; | &nbsp;&nbsp;.&nbsp; | &nbsp;&nbsp;3&nbsp; | &nbsp;&nbsp;.&nbsp; | &nbsp;&nbsp;.&nbsp; | &nbsp;&nbsp;.&nbsp; | &nbsp;&nbsp;.&nbsp; | &nbsp;&nbsp;.&nbsp; | &nbsp;&nbsp;.&nbsp; | &nbsp;&nbsp;.&nbsp; | &nbsp;&nbsp;.&nbsp; | &nbsp;&nbsp;.&nbsp; | &nbsp;&nbsp;.&nbsp; | &nbsp;&nbsp;.&nbsp; | &nbsp;&nbsp;.&nbsp; | &nbsp;&nbsp;.&nbsp; | &nbsp;&nbsp;.&nbsp; | &nbsp;&nbsp;.&nbsp; | &nbsp;&nbsp;.&nbsp; | &nbsp;&nbsp;.&nbsp; | &nbsp;&nbsp;.&nbsp; |  &nbsp;&nbsp;3&nbsp; | &nbsp;&nbsp;idler.stl |
| &nbsp;&nbsp;.&nbsp; | &nbsp;&nbsp;.&nbsp; | &nbsp;&nbsp;.&nbsp; | &nbsp;&nbsp;3&nbsp; | &nbsp;&nbsp;.&nbsp; | &nbsp;&nbsp;.&nbsp; | &nbsp;&nbsp;.&nbsp; | &nbsp;&nbsp;.&nbsp; | &nbsp;&nbsp;.&nbsp; | &nbsp;&nbsp;.&nbsp; | &nbsp;&nbsp;.&nbsp; | &nbsp;&nbsp;.&nbsp; | &nbsp;&nbsp;.&nbsp; | &nbsp;&nbsp;.&nbsp; | &nbsp;&nbsp;.&nbsp; | &nbsp;&nbsp;.&nbsp; | &nbsp;&nbsp;.&nbsp; | &nbsp;&nbsp;.&nbsp; | &nbsp;&nbsp;.&nbsp; | &nbsp;&nbsp;.&nbsp; | &nbsp;&nbsp;.&nbsp; | &nbsp;&nbsp;.&nbsp; |  &nbsp;&nbsp;3&nbsp; | &nbsp;&nbsp;idler_spacers.stl |
| &nbsp;&nbsp;1&nbsp; | &nbsp;&nbsp;.&nbsp; | &nbsp;&nbsp;.&nbsp; | &nbsp;&nbsp;.&nbsp; | &nbsp;&nbsp;.&nbsp; | &nbsp;&nbsp;.&nbsp; | &nbsp;&nbsp;.&nbsp; | &nbsp;&nbsp;.&nbsp; | &nbsp;&nbsp;.&nbsp; | &nbsp;&nbsp;.&nbsp; | &nbsp;&nbsp;.&nbsp; | &nbsp;&nbsp;.&nbsp; | &nbsp;&nbsp;.&nbsp; | &nbsp;&nbsp;.&nbsp; | &nbsp;&nbsp;.&nbsp; | &nbsp;&nbsp;.&nbsp; | &nbsp;&nbsp;.&nbsp; | &nbsp;&nbsp;.&nbsp; | &nbsp;&nbsp;.&nbsp; | &nbsp;&nbsp;.&nbsp; | &nbsp;&nbsp;.&nbsp; | &nbsp;&nbsp;.&nbsp; |  &nbsp;&nbsp;1&nbsp; | &nbsp;&nbsp;left_pcb_mount.stl |
| &nbsp;&nbsp;.&nbsp; | &nbsp;&nbsp;.&nbsp; | &nbsp;&nbsp;.&nbsp; | &nbsp;&nbsp;.&nbsp; | &nbsp;&nbsp;.&nbsp; | &nbsp;&nbsp;.&nbsp; | &nbsp;&nbsp;.&nbsp; | &nbsp;&nbsp;.&nbsp; | &nbsp;&nbsp;.&nbsp; | &nbsp;&nbsp;.&nbsp; | &nbsp;&nbsp;.&nbsp; | &nbsp;&nbsp;.&nbsp; | &nbsp;&nbsp;.&nbsp; | &nbsp;&nbsp;.&nbsp; | &nbsp;&nbsp;3&nbsp; | &nbsp;&nbsp;.&nbsp; | &nbsp;&nbsp;.&nbsp; | &nbsp;&nbsp;.&nbsp; | &nbsp;&nbsp;.&nbsp; | &nbsp;&nbsp;.&nbsp; | &nbsp;&nbsp;.&nbsp; | &nbsp;&nbsp;.&nbsp; |  &nbsp;&nbsp;3&nbsp; | &nbsp;&nbsp;rail_guard.stl |
| &nbsp;&nbsp;.&nbsp; | &nbsp;&nbsp;.&nbsp; | &nbsp;&nbsp;.&nbsp; | &nbsp;&nbsp;.&nbsp; | &nbsp;&nbsp;.&nbsp; | &nbsp;&nbsp;.&nbsp; | &nbsp;&nbsp;.&nbsp; | &nbsp;&nbsp;.&nbsp; | &nbsp;&nbsp;.&nbsp; | &nbsp;&nbsp;.&nbsp; | &nbsp;&nbsp;.&nbsp; | &nbsp;&nbsp;.&nbsp; | &nbsp;&nbsp;.&nbsp; | &nbsp;&nbsp;.&nbsp; | &nbsp;&nbsp;.&nbsp; | &nbsp;&nbsp;.&nbsp; | &nbsp;&nbsp;.&nbsp; | &nbsp;&nbsp;.&nbsp; | &nbsp;&nbsp;.&nbsp; | &nbsp;&nbsp;.&nbsp; | &nbsp;&nbsp;.&nbsp; | &nbsp;&nbsp;4&nbsp; |  &nbsp;&nbsp;4&nbsp; | &nbsp;&nbsp;rail_helper.stl |
| &nbsp;&nbsp;1&nbsp; | &nbsp;&nbsp;.&nbsp; | &nbsp;&nbsp;.&nbsp; | &nbsp;&nbsp;.&nbsp; | &nbsp;&nbsp;.&nbsp; | &nbsp;&nbsp;.&nbsp; | &nbsp;&nbsp;.&nbsp; | &nbsp;&nbsp;.&nbsp; | &nbsp;&nbsp;.&nbsp; | &nbsp;&nbsp;.&nbsp; | &nbsp;&nbsp;.&nbsp; | &nbsp;&nbsp;.&nbsp; | &nbsp;&nbsp;.&nbsp; | &nbsp;&nbsp;.&nbsp; | &nbsp;&nbsp;.&nbsp; | &nbsp;&nbsp;.&nbsp; | &nbsp;&nbsp;.&nbsp; | &nbsp;&nbsp;.&nbsp; | &nbsp;&nbsp;.&nbsp; | &nbsp;&nbsp;.&nbsp; | &nbsp;&nbsp;.&nbsp; | &nbsp;&nbsp;.&nbsp; |  &nbsp;&nbsp;1&nbsp; | &nbsp;&nbsp;right_pcb_mount.stl |
| &nbsp;&nbsp;.&nbsp; | &nbsp;&nbsp;.&nbsp; | &nbsp;&nbsp;.&nbsp; | &nbsp;&nbsp;.&nbsp; | &nbsp;&nbsp;3&nbsp; | &nbsp;&nbsp;.&nbsp; | &nbsp;&nbsp;.&nbsp; | &nbsp;&nbsp;.&nbsp; | &nbsp;&nbsp;.&nbsp; | &nbsp;&nbsp;.&nbsp; | &nbsp;&nbsp;.&nbsp; | &nbsp;&nbsp;.&nbsp; | &nbsp;&nbsp;.&nbsp; | &nbsp;&nbsp;.&nbsp; | &nbsp;&nbsp;.&nbsp; | &nbsp;&nbsp;.&nbsp; | &nbsp;&nbsp;.&nbsp; | &nbsp;&nbsp;.&nbsp; | &nbsp;&nbsp;.&nbsp; | &nbsp;&nbsp;.&nbsp; | &nbsp;&nbsp;.&nbsp; | &nbsp;&nbsp;.&nbsp; |  &nbsp;&nbsp;3&nbsp; | &nbsp;&nbsp;top_corner.stl |
| &nbsp;&nbsp;2&nbsp; | &nbsp;&nbsp;1&nbsp; | &nbsp;&nbsp;.&nbsp; | &nbsp;&nbsp;6&nbsp; | &nbsp;&nbsp;3&nbsp; | &nbsp;&nbsp;3&nbsp; | &nbsp;&nbsp;3&nbsp; | &nbsp;&nbsp;3&nbsp; | &nbsp;&nbsp;.&nbsp; | &nbsp;&nbsp;3&nbsp; | &nbsp;&nbsp;3&nbsp; | &nbsp;&nbsp;.&nbsp; | &nbsp;&nbsp;.&nbsp; | &nbsp;&nbsp;6&nbsp; | &nbsp;&nbsp;3&nbsp; | &nbsp;&nbsp;.&nbsp; | &nbsp;&nbsp;.&nbsp; | &nbsp;&nbsp;.&nbsp; | &nbsp;&nbsp;.&nbsp; | &nbsp;&nbsp;.&nbsp; | &nbsp;&nbsp;.&nbsp; | &nbsp;&nbsp;4&nbsp; | &nbsp;&nbsp;40&nbsp; | &nbsp;&nbsp;Total 3D printed parts count |

<span></span>
[Top](#TOP)

---

## Duet Assembly
### Vitamins
|Qty|Description|
|---:|:---|
|1| Cat 5 patch cable 300mm|
|1| Duet 2 Ethernet electronics|
|1| Micro SD card|
|4| Nut M5 sliding T|
|4| Screw M3 cap x  6mm|
|4| Screw M5 flanged x 16mm|

### 3D Printed parts

| 1 x left_pcb_mount.stl | 1 x right_pcb_mount.stl |
|---|---|
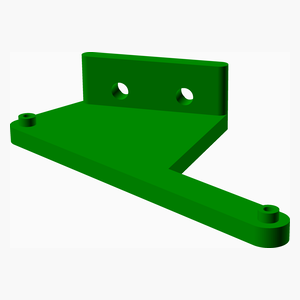
[picture p2: stls/left_pcb_mount.png]
left_pcb_mount.stl
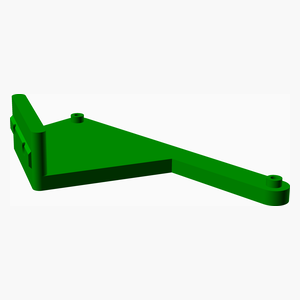
[picture p3: stls/right_pcb_mount.png]
right_pcb_mount.stl
|  |  

### Assembly instructions
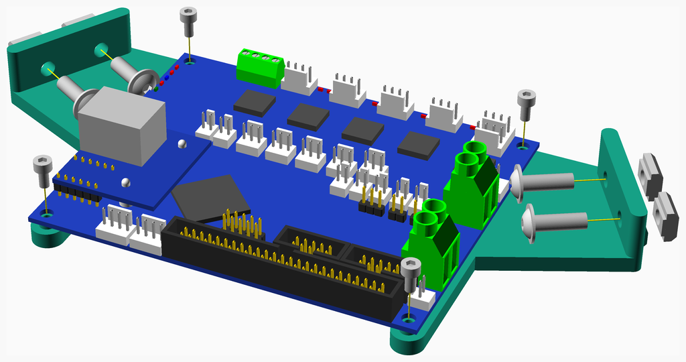
[picture p4: assemblies/duet_assembly.png]
duet_assembly


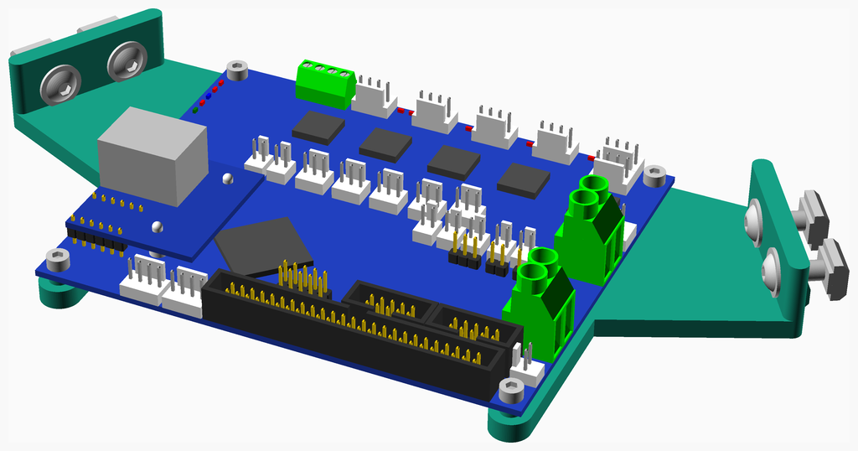
[picture p5: assemblies/duet_assembled.png]
duet_assembled


<span></span>
[Top](#TOP)

---

## Effector Assembly
### 3D Printed parts

| 1 x effector.stl |
|---|
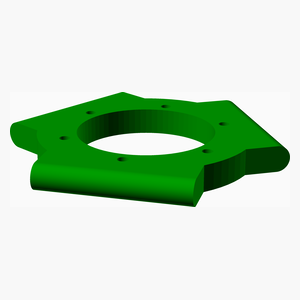
[picture p6: stls/effector.png]
effector.stl
|  

### Assembly instructions
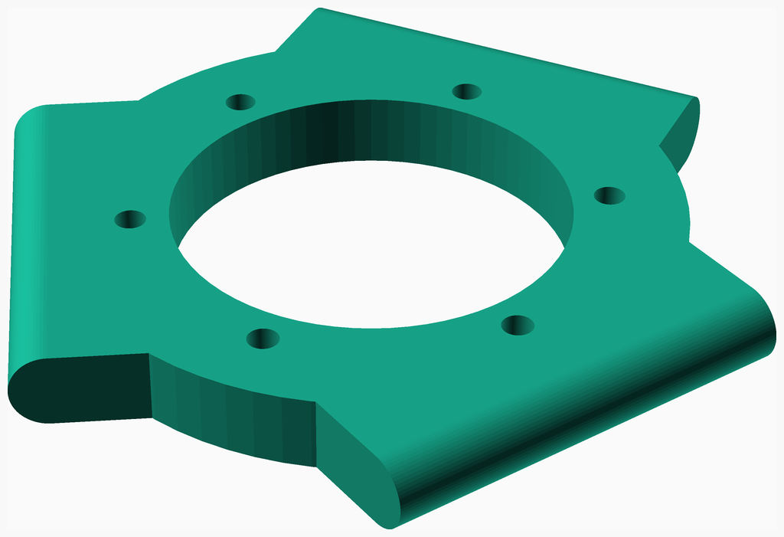
[picture p7: assemblies/effector_assembly.png]
effector_assembly


effector_assembled

<span></span>
[Top](#TOP)

---

## 3 x Idler Bearing Assembly
### Vitamins
|Qty|Description|
|---:|:---|
|6| Ball bearing F625ZZ 5mm x 16mm x 5mm|
|6| Washer  M5 x 10mm x 1mm|

### Assembly instructions
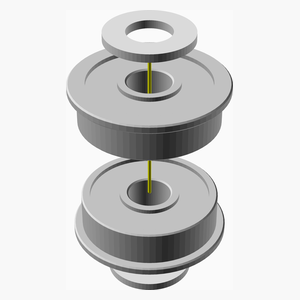
[picture p8: assemblies/idler_bearing_assembly_tn.png]
idler_bearing_assembly


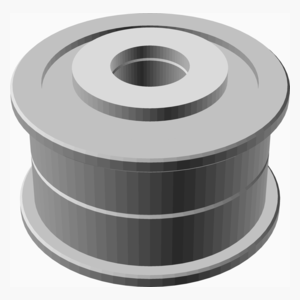
[picture p9: assemblies/idler_bearing_assembled_tn.png]
idler_bearing_assembled


<span></span>
[Top](#TOP)

---

## 3 x Idler Assembly
### Vitamins
|Qty|Description|
|---:|:---|
|12| Nut M4 sliding T|
|3| Nut M5 sliding T|
|12| Screw M4 flanged x 10mm|
|3| Screw M5 flanged x 49mm|

### 3D Printed parts

| 3 x idler.stl | 3 x idler_spacers.stl |
|---|---|
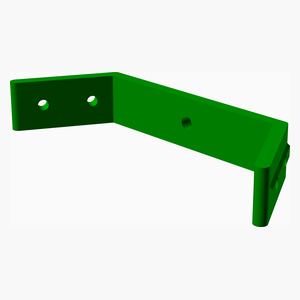
[picture p10: stls/idler.png]
idler.stl
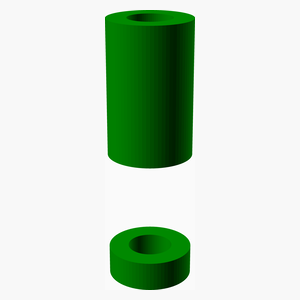
[picture p11: stls/idler_spacers.png]
idler_spacers.stl
|  |  

### Sub-assemblies

| 3 x idler_bearing_assembly |
|---|
| idler_bearing_assembled 

### Assembly instructions
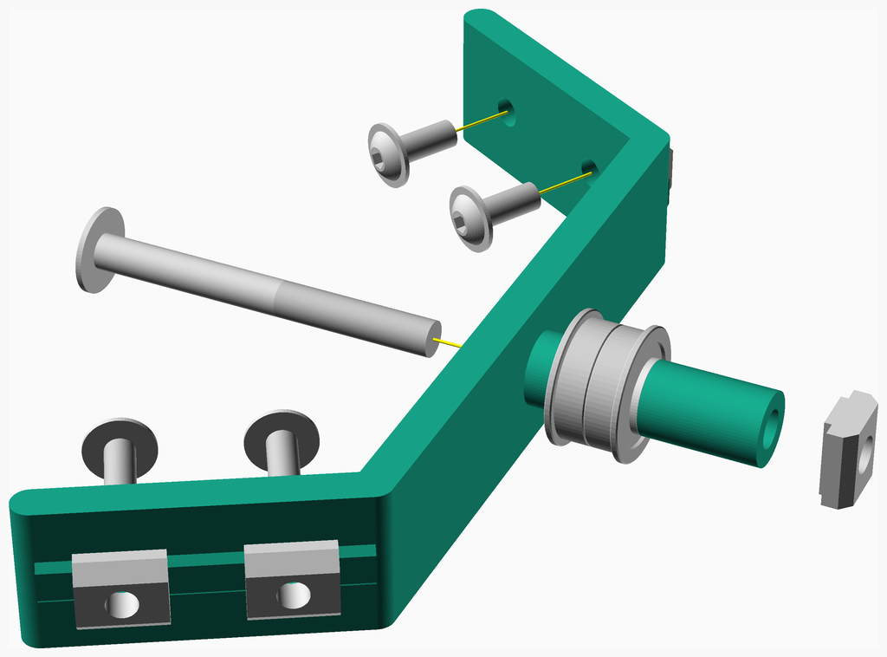
[picture p12: assemblies/idler_assembly.png]
idler_assembly


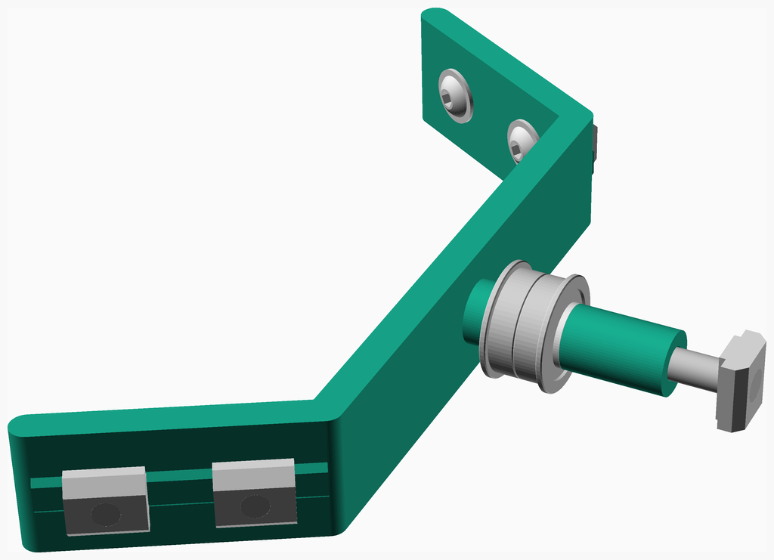
[picture p13: assemblies/idler_assembled.png]
idler_assembled


<span></span>
[Top](#TOP)

---

## 3 x Top Corner Assembly
### Vitamins
|Qty|Description|
|---:|:---|
|3| Extrusion E2020 x 300mm|
|24| Nut M4 sliding T|
|9| Nut M5 sliding T|
|24| Screw M4 flanged x 10mm|
|9| Screw M5 flanged x 16mm|

### 3D Printed parts

| 3 x top_corner.stl |
|---|
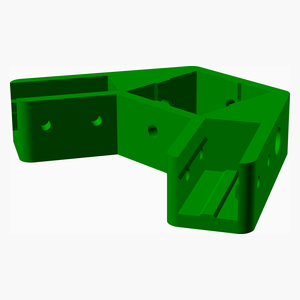
[picture p14: stls/top_corner.png]
top_corner.stl
|  

### Sub-assemblies

| 3 x idler_assembly |
|---|
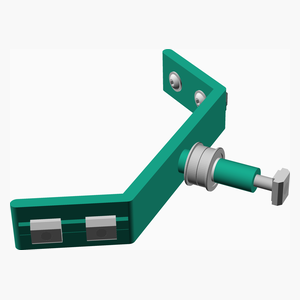
[picture p15: assemblies/idler_assembled_tn.png]
idler_assembled
|  

### Assembly instructions
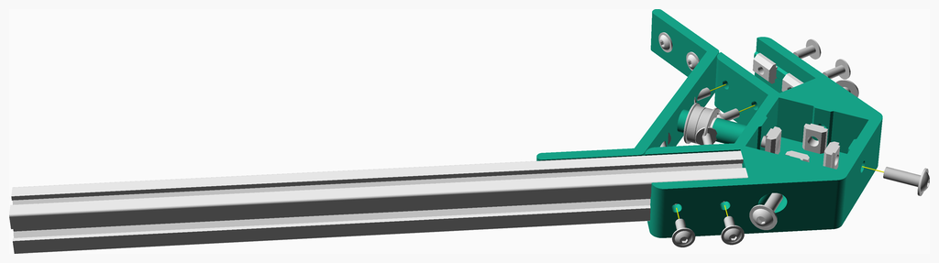
[picture p16: assemblies/top_corner_assembly.png]
top_corner_assembly


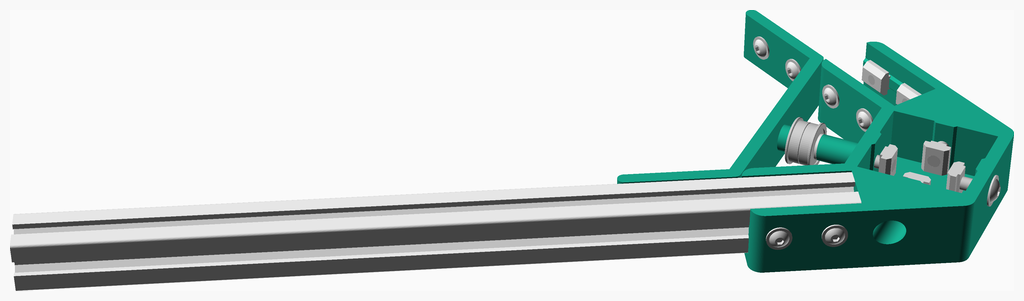
[picture p17: assemblies/top_corner_assembled.png]
top_corner_assembled


<span></span>
[Top](#TOP)

---

## 3 x Bottom Motor Mount Assembly
### Vitamins
|Qty|Description|
|---:|:---|
|24| Nut M4 sliding T|
|3| Pulley GT2OB 20 teeth|
|12| Screw M3 cap x  8mm|
|6| Screw M3 grub x  6mm|
|24| Screw M4 flanged x 10mm|
|3| Stepper motor NEMA17 x 47mm (5x24 shaft)|
|12| Washer  M3 x 7mm x 0.5mm|

### 3D Printed parts

| 3 x bottom_motor_mount.stl |
|---|
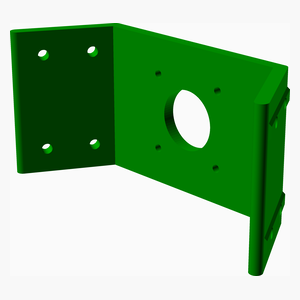
[picture p18: stls/bottom_motor_mount.png]
bottom_motor_mount.stl
|  

### Assembly instructions
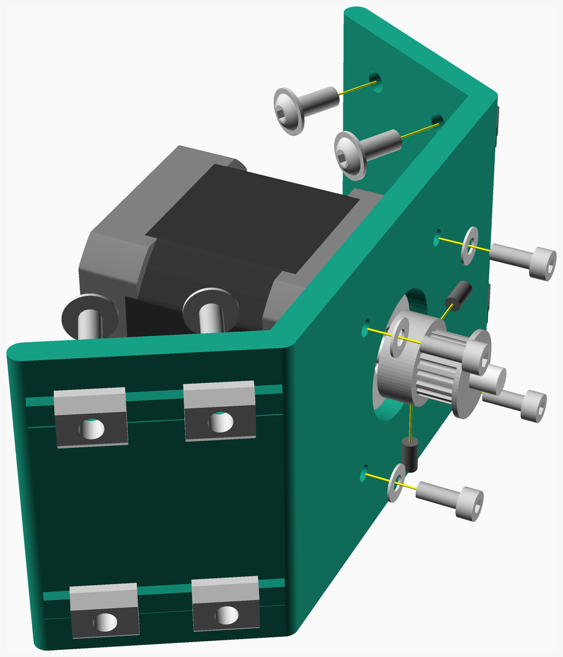
[picture p19: assemblies/bottom_motor_mount_assembly.png]
bottom_motor_mount_assembly


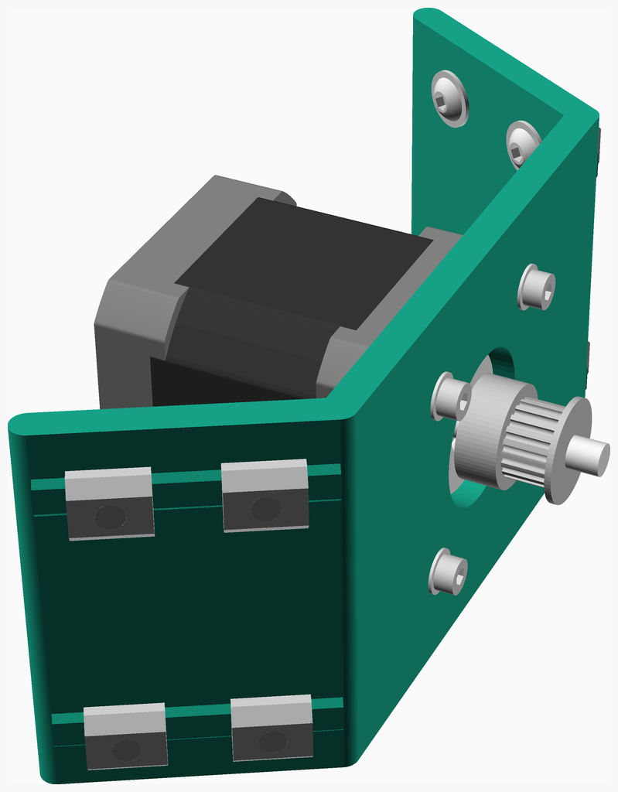
[picture p20: assemblies/bottom_motor_mount_assembled.png]
bottom_motor_mount_assembled


<span></span>
[Top](#TOP)

---

## 3 x Bed Mount Right Assembly
### Vitamins
|Qty|Description|
|---:|:---|
|6| Nut M4 sliding T|
|6| Screw M4 flanged x 10mm|
|3| Screw M6 cap x 10mm|
|3| Washer rubber M6 x 12.5mm x 1.5mm|

### 3D Printed parts

| 3 x bed_mount_right.stl |
|---|
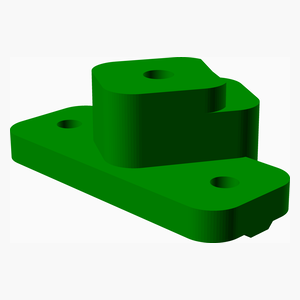
[picture p21: stls/bed_mount_right.png]
bed_mount_right.stl
|  

### Assembly instructions
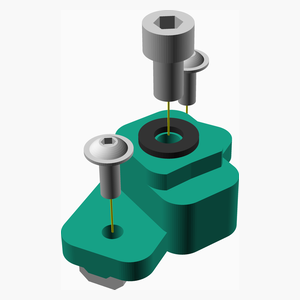
[picture p22: assemblies/bed_mount_right_assembly_tn.png]
bed_mount_right_assembly


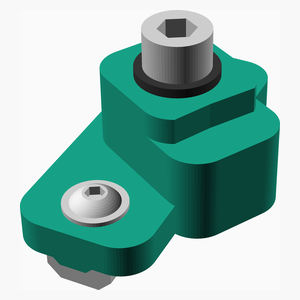
[picture p23: assemblies/bed_mount_right_assembled_tn.png]
bed_mount_right_assembled


<span></span>
[Top](#TOP)

---

## 3 x Bed Mount Left Assembly
### Vitamins
|Qty|Description|
|---:|:---|
|6| Nut M4 sliding T|
|6| Screw M4 flanged x 10mm|
|3| Screw M6 cap x 10mm|
|3| Washer rubber M6 x 12.5mm x 1.5mm|

### 3D Printed parts

| 3 x bed_mount_left.stl |
|---|
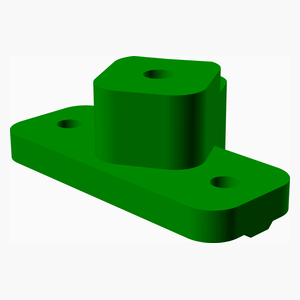
[picture p24: stls/bed_mount_left.png]
bed_mount_left.stl
|  

### Assembly instructions
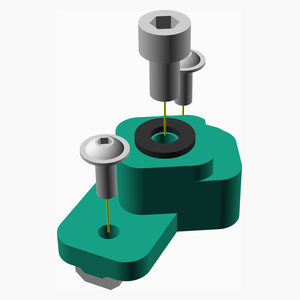
[picture p25: assemblies/bed_mount_left_assembly_tn.png]
bed_mount_left_assembly


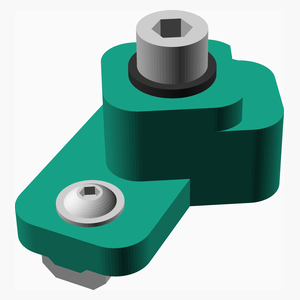
[picture p26: assemblies/bed_mount_left_assembled_tn.png]
bed_mount_left_assembled


<span></span>
[Top](#TOP)

---

## 3 x Bottom Extrusion Assembly
### Vitamins
|Qty|Description|
|---:|:---|
|3| Extrusion E2020 x 300mm|

### Sub-assemblies

| 3 x bed_mount_left_assembly | 3 x bed_mount_right_assembly |
|---|---|
| bed_mount_left_assembled | bed_mount_right_assembled 

### Assembly instructions
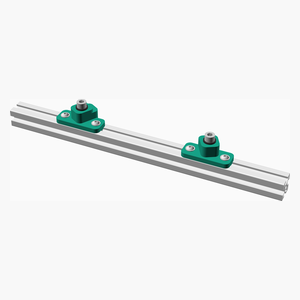
[picture p27: assemblies/bottom_extrusion_assembly_tn.png]
bottom_extrusion_assembly


bottom_extrusion_assembled

<span></span>
[Top](#TOP)

---

## 3 x Bottom Corner Bottom Assembly
### Vitamins
|Qty|Description|
|---:|:---|
|24| Heatfit insert M3 x 4mm|

### 3D Printed parts

| 3 x bottom_corner_bottom.stl |
|---|
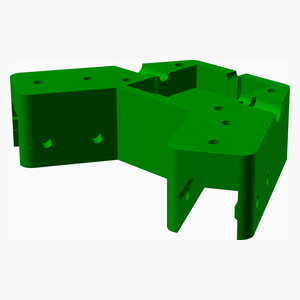
[picture p28: stls/bottom_corner_bottom.png]
bottom_corner_bottom.stl
|  

### Assembly instructions
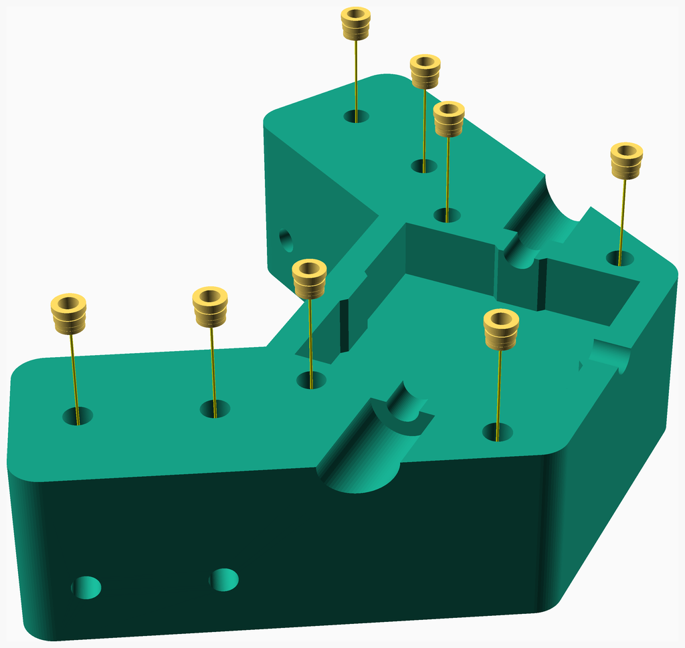
[picture p29: assemblies/bottom_corner_bottom_assembly.png]
bottom_corner_bottom_assembly


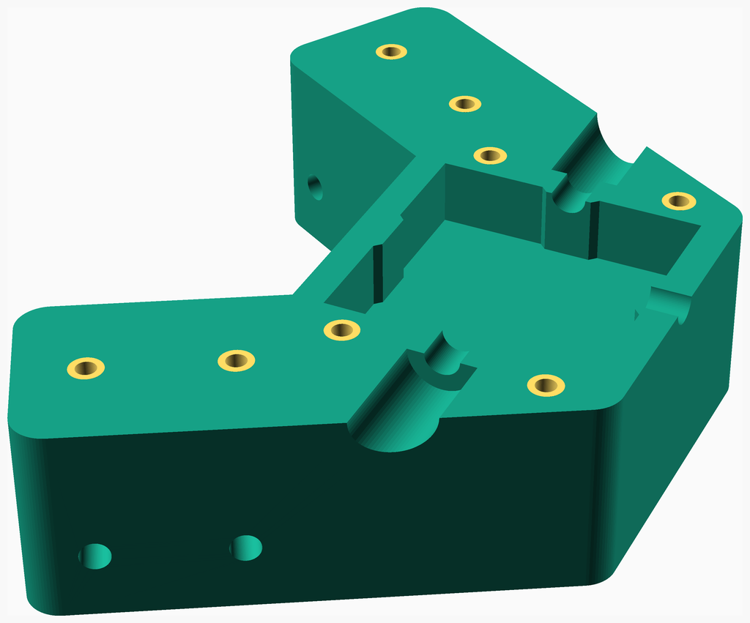
[picture p30: assemblies/bottom_corner_bottom_assembled.png]
bottom_corner_bottom_assembled


<span></span>
[Top](#TOP)

---

## 3 x Two Part Bottom Corner Assembly
### Vitamins
|Qty|Description|
|---:|:---|
|24| Screw M3 cap x 10mm|

### 3D Printed parts

| 3 x bottom_corner_top.stl |
|---|
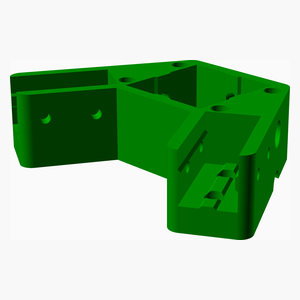
[picture p31: stls/bottom_corner_top.png]
bottom_corner_top.stl
|  

### Sub-assemblies

| 3 x bottom_corner_bottom_assembly |
|---|
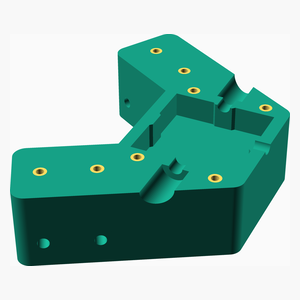
[picture p32: assemblies/bottom_corner_bottom_assembled_tn.png]
bottom_corner_bottom_assembled
|  

### Assembly instructions
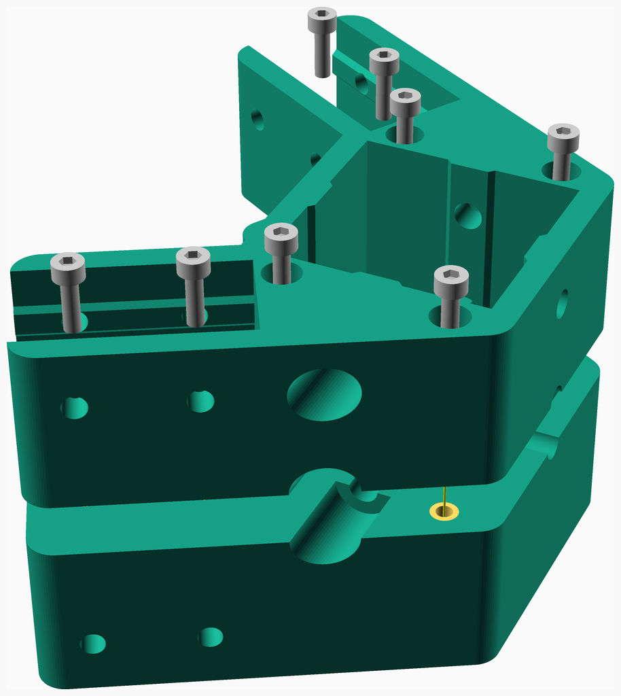
[picture p33: assemblies/two_part_bottom_corner_assembly.png]
two_part_bottom_corner_assembly


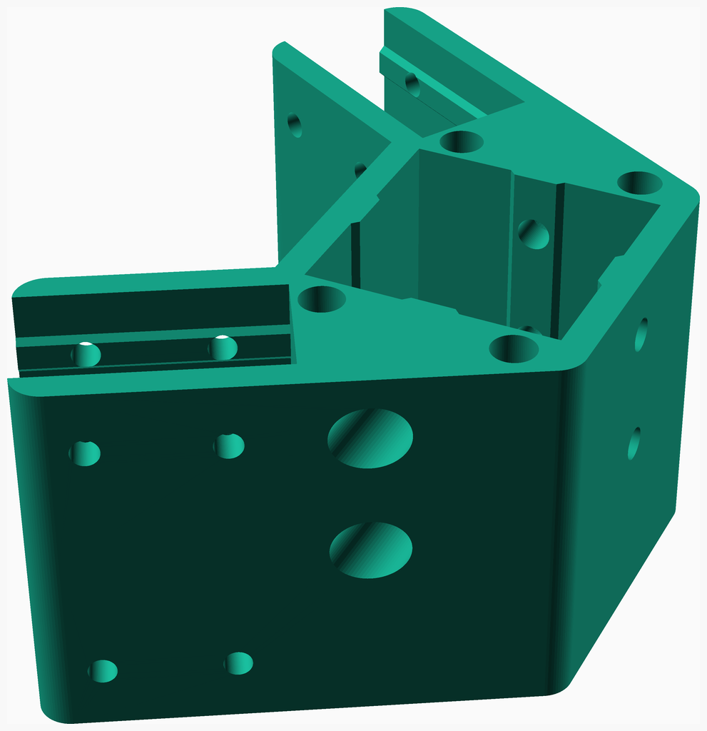
[picture p34: assemblies/two_part_bottom_corner_assembled.png]
two_part_bottom_corner_assembled


<span></span>
[Top](#TOP)

---

## 3 x Bottom Corner Assembly
### Vitamins
|Qty|Description|
|---:|:---|
|3| Extrusion E2020 x 300mm|
|48| Nut M4 sliding T|
|18| Nut M5 sliding T|
|48| Screw M4 flanged x 10mm|
|18| Screw M5 flanged x 16mm|

### Sub-assemblies

| 3 x bottom_extrusion_assembly | 3 x bottom_motor_mount_assembly | 3 x two_part_bottom_corner_assembly |
|---|---|---|
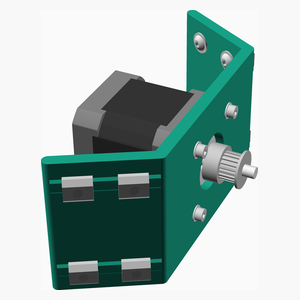
[picture p35: assemblies/bottom_motor_mount_assembled_tn.png]
bottom_motor_mount_assembled
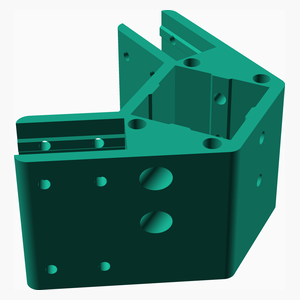
[picture p36: assemblies/two_part_bottom_corner_assembled_tn.png]
two_part_bottom_corner_assembled
| bottom_extrusion_assembled |  |  

### Assembly instructions
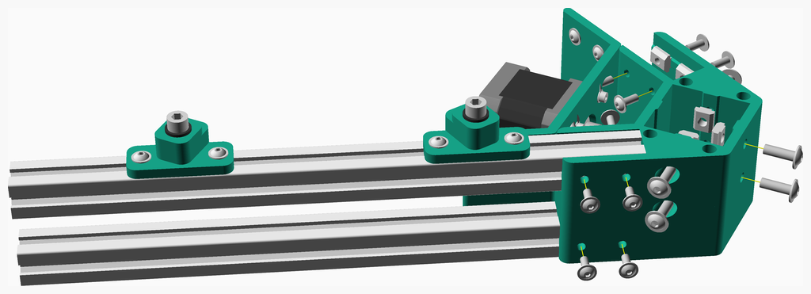
[picture p37: assemblies/bottom_corner_assembly.png]
bottom_corner_assembly


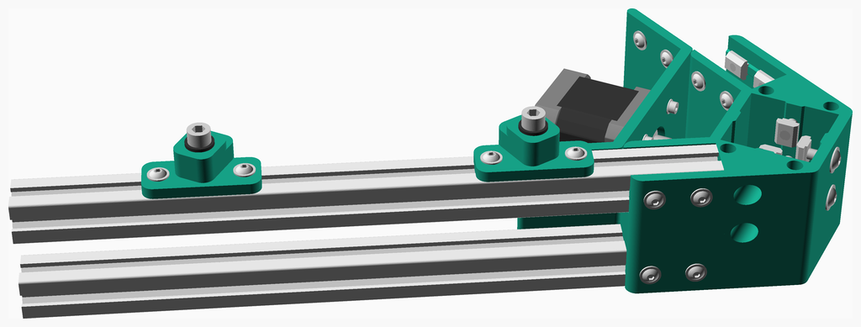
[picture p38: assemblies/bottom_corner_assembled.png]
bottom_corner_assembled


<span></span>
[Top](#TOP)

---

## 3 x Arm Assembly
### Vitamins
|Qty|Description|
|---:|:---|
|6| CF rod 3mm x 231mm|

### Assembly instructions
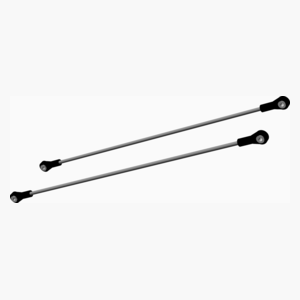
[picture p39: assemblies/arm_assembly_tn.png]
arm_assembly


arm_assembled

<span></span>
[Top](#TOP)

---

## 3 x Carriage Assembly
### Vitamins
|Qty|Description|
|---:|:---|
|3| Linear rail carriage MGN12H|
|3| Nut M3 x 2.4mm |
|6| Nut M3 x 2.4mm nyloc|
|12| Screw M3 cap x 10mm|
|9| Screw M3 cap x 20mm|
|24| Washer  M3 x 7mm x 0.5mm|

### 3D Printed parts

| 3 x carriage.stl | 3 x carriage_belt_tensioner.stl |
|---|---|
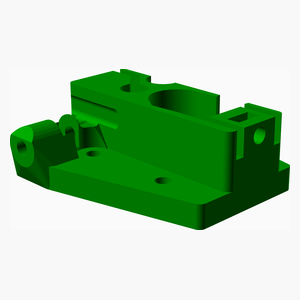
[picture p40: stls/carriage.png]
carriage.stl
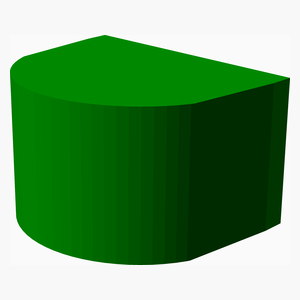
[picture p41: stls/carriage_belt_tensioner.png]
carriage_belt_tensioner.stl
|  |  

### Sub-assemblies

| 3 x arm_assembly |
|---|
| arm_assembled 

### Assembly instructions
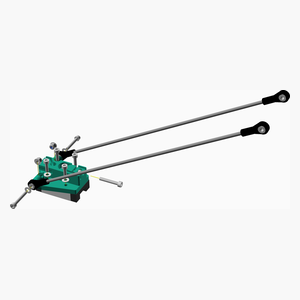
[picture p42: assemblies/carriage_assembly_tn.png]
carriage_assembly


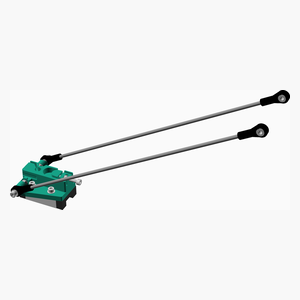
[picture p43: assemblies/carriage_assembled_tn.png]
carriage_assembled


<span></span>
[Top](#TOP)

---

## 3 x Rail Guard Assembly
### Vitamins
|Qty|Description|
|---:|:---|
|3| Nut M5 sliding T|
|3| Screw M5 flanged x 16mm|

### 3D Printed parts

| 3 x rail_guard.stl |
|---|
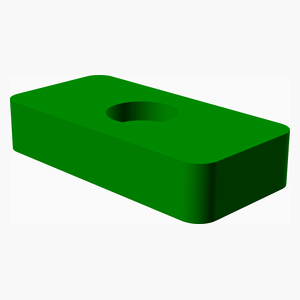
[picture p44: stls/rail_guard.png]
rail_guard.stl
|  

### Assembly instructions
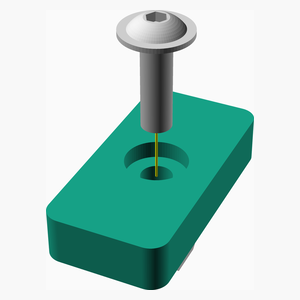
[picture p45: assemblies/rail_guard_assembly_tn.png]
rail_guard_assembly


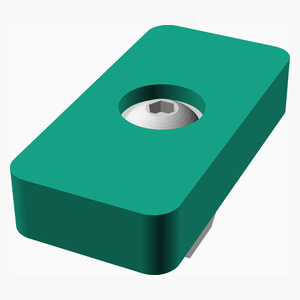
[picture p46: assemblies/rail_guard_assembled_tn.png]
rail_guard_assembled


<span></span>
[Top](#TOP)

---

## Upright C Assembly
### Vitamins
|Qty|Description|
|---:|:---|
|1| Extrusion E4040 x 1000mm|
|1| Linear rail MGN12 x 800mm|
|18| Screw M3 cap x 16mm|

### Sub-assemblies

| 1 x carriage_assembly | 1 x rail_guard_assembly |
|---|---|
| carriage_assembled | rail_guard_assembled 

### Assembly instructions
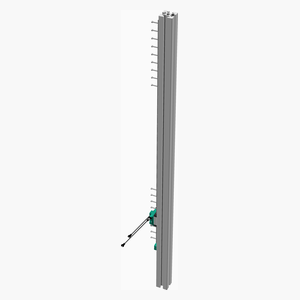
[picture p47: assemblies/upright_c_assembly_tn.png]
upright_c_assembly


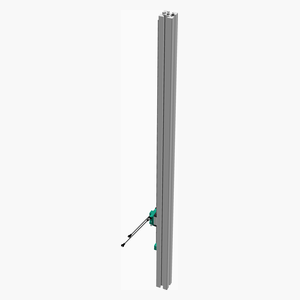
[picture p48: assemblies/upright_c_assembled_tn.png]
upright_c_assembled


<span></span>
[Top](#TOP)

---

## Tower C Assembly
### Vitamins
|Qty|Description|
|---:|:---|
|1| Belt GT2 x 6mm x 2072mm|

### Sub-assemblies

| 1 x bottom_corner_assembly | 1 x top_corner_assembly | 1 x upright_c_assembly |
|---|---|---|
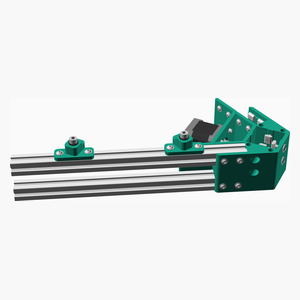
[picture p49: assemblies/bottom_corner_assembled_tn.png]
bottom_corner_assembled
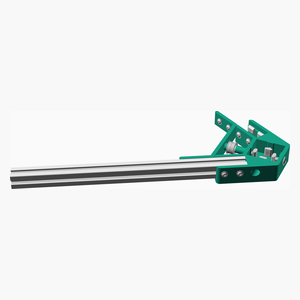
[picture p50: assemblies/top_corner_assembled_tn.png]
top_corner_assembled
|  |  | upright_c_assembled 

### Assembly instructions
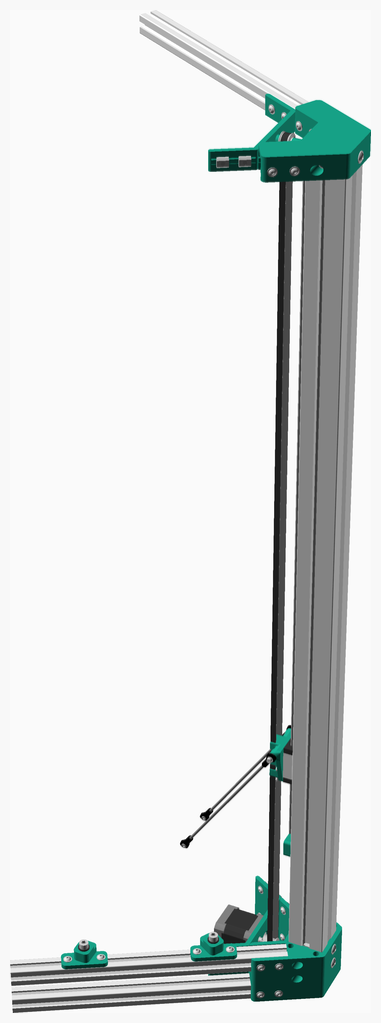
[picture p51: assemblies/tower_c_assembly.png]
tower_c_assembly


tower_c_assembled

<span></span>
[Top](#TOP)

---

## Upright B Assembly
### Vitamins
|Qty|Description|
|---:|:---|
|1| Extrusion E4040 x 1000mm|
|1| Linear rail MGN12 x 800mm|
|18| Screw M3 cap x 16mm|

### Sub-assemblies

| 1 x carriage_assembly | 1 x rail_guard_assembly |
|---|---|
| carriage_assembled | rail_guard_assembled 

### Assembly instructions
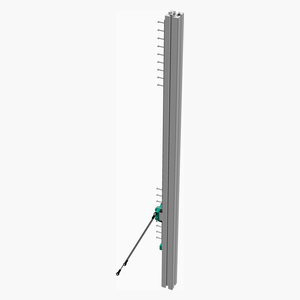
[picture p52: assemblies/upright_b_assembly_tn.png]
upright_b_assembly


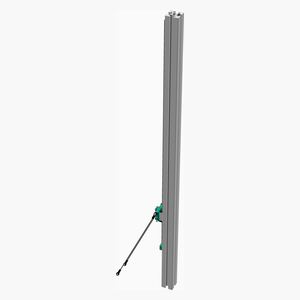
[picture p53: assemblies/upright_b_assembled_tn.png]
upright_b_assembled


<span></span>
[Top](#TOP)

---

## Tower B Assembly
### Vitamins
|Qty|Description|
|---:|:---|
|1| Belt GT2 x 6mm x 2072mm|

### Sub-assemblies

| 1 x bottom_corner_assembly | 1 x top_corner_assembly | 1 x upright_b_assembly |
|---|---|---|
| bottom_corner_assembled | top_corner_assembled | upright_b_assembled 

### Assembly instructions
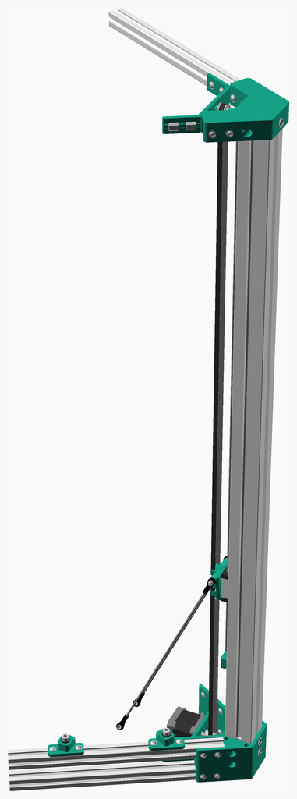
[picture p54: assemblies/tower_b_assembly.png]
tower_b_assembly


tower_b_assembled

<span></span>
[Top](#TOP)

---

## Upright A Assembly
### Vitamins
|Qty|Description|
|---:|:---|
|1| Extrusion E4040 x 1000mm|
|1| Linear rail MGN12 x 800mm|
|18| Screw M3 cap x 16mm|

### Sub-assemblies

| 1 x carriage_assembly | 1 x rail_guard_assembly |
|---|---|
| carriage_assembled | rail_guard_assembled 

### Assembly instructions
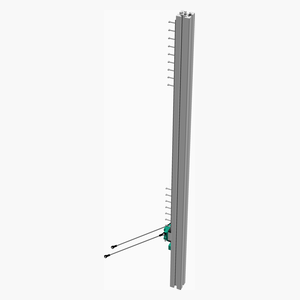
[picture p55: assemblies/upright_a_assembly_tn.png]
upright_a_assembly


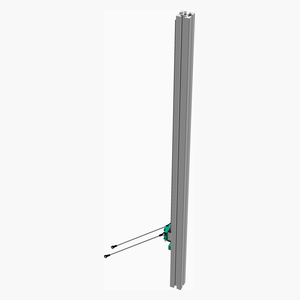
[picture p56: assemblies/upright_a_assembled_tn.png]
upright_a_assembled


<span></span>
[Top](#TOP)

---

## Tower A Assembly
### Vitamins
|Qty|Description|
|---:|:---|
|1| Belt GT2 x 6mm x 2072mm|

### Sub-assemblies

| 1 x bottom_corner_assembly | 1 x top_corner_assembly | 1 x upright_a_assembly |
|---|---|---|
| bottom_corner_assembled | top_corner_assembled | upright_a_assembled 

### Assembly instructions
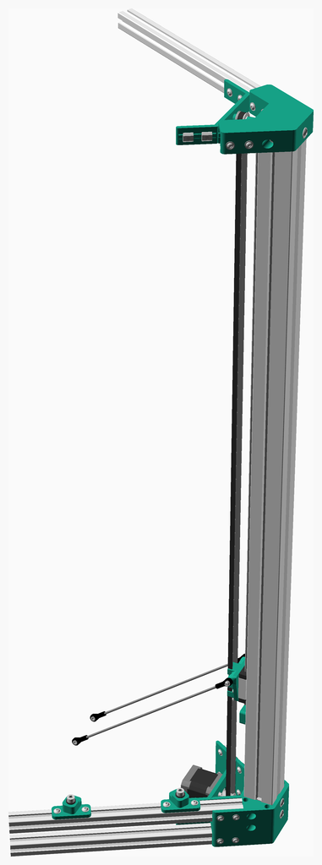
[picture p57: assemblies/tower_a_assembly.png]
tower_a_assembly


tower_a_assembled

<span></span>
[Top](#TOP)

---

## Main Assembly
### 3D Printed parts

| 4 x rail_helper.stl |
|---|
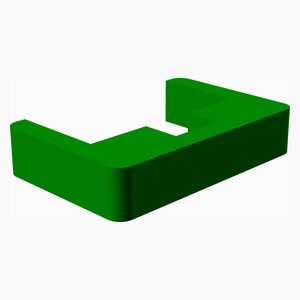
[picture p58: stls/rail_helper.png]
rail_helper.stl
|  

### Sub-assemblies

| 1 x duet_assembly | 1 x effector_assembly | 1 x tower_a_assembly |
|---|---|---|
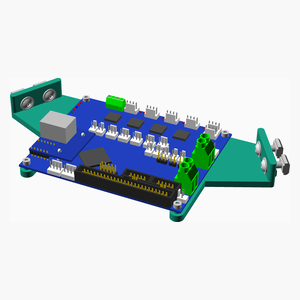
[picture p59: assemblies/duet_assembled_tn.png]
duet_assembled
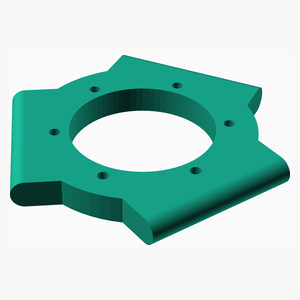
[picture p60: assemblies/effector_assembled_tn.png]
effector_assembled
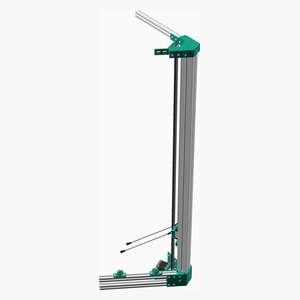
[picture p61: assemblies/tower_a_assembled_tn.png]
tower_a_assembled
|  |  |  

| 1 x tower_b_assembly | 1 x tower_c_assembly |
|---|---|
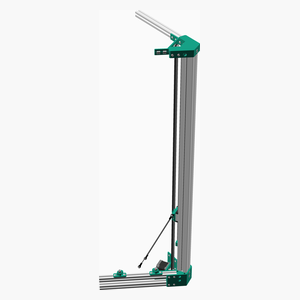
[picture p62: assemblies/tower_b_assembled_tn.png]
tower_b_assembled
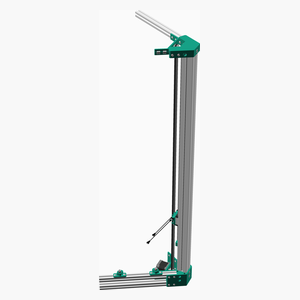
[picture p63: assemblies/tower_c_assembled_tn.png]
tower_c_assembled
|  |  

### Assembly instructions
main_assembly

Insert PSU

main_assembled

<span></span>
[Top](#TOP)
