beanz/typhon-scad/stls/bottom_corner_bottom.stl

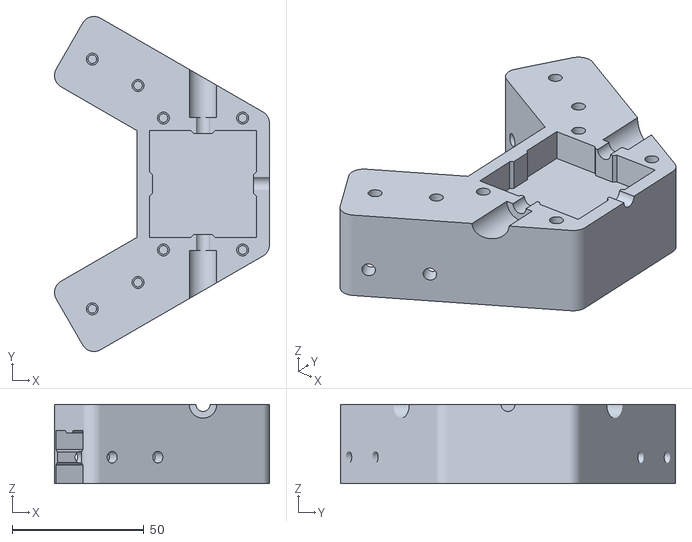
[picture p64: CAD file, 2024-10-30]
stls/bottom_corner_bottom.stl
81.5 x 127.0 x 30.0
