beanz/typhon-scad/stls/left_pcb_mount.stl

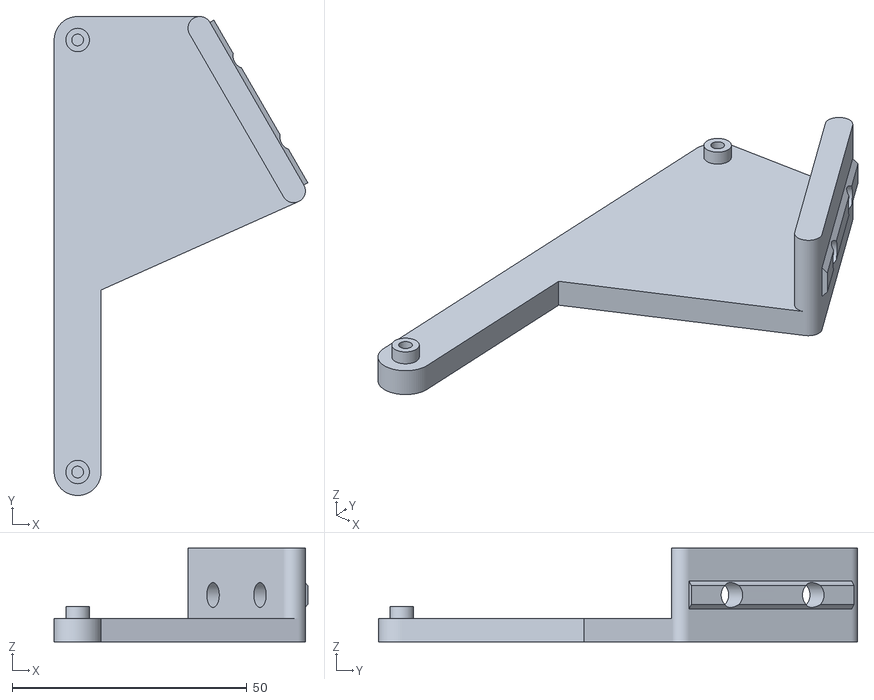
[picture p65: CAD file, 2024-10-30]
stls/left_pcb_mount.stl
54.0 x 102.0 x 20.0
