beanz/typhon-scad/stls/idler_spacers.stl

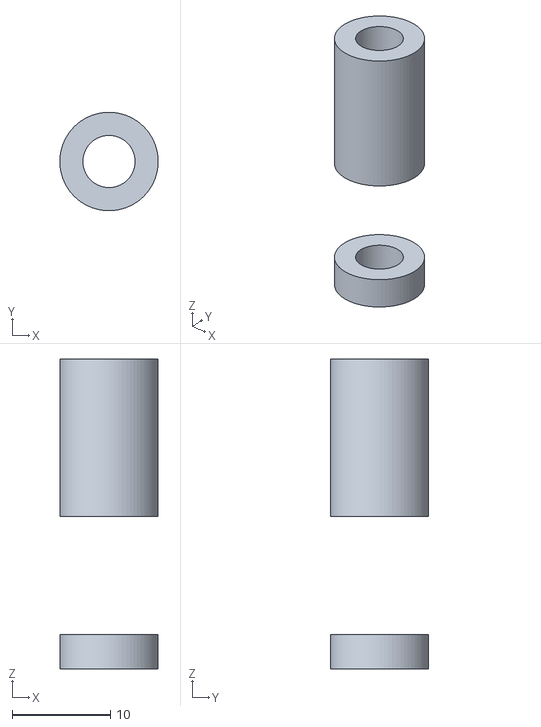
[picture p66: CAD file, 2024-10-30]
stls/idler_spacers.stl
10.0 x 10.0 x 31.5
