beanz/typhon-scad/stls/carriage.stl

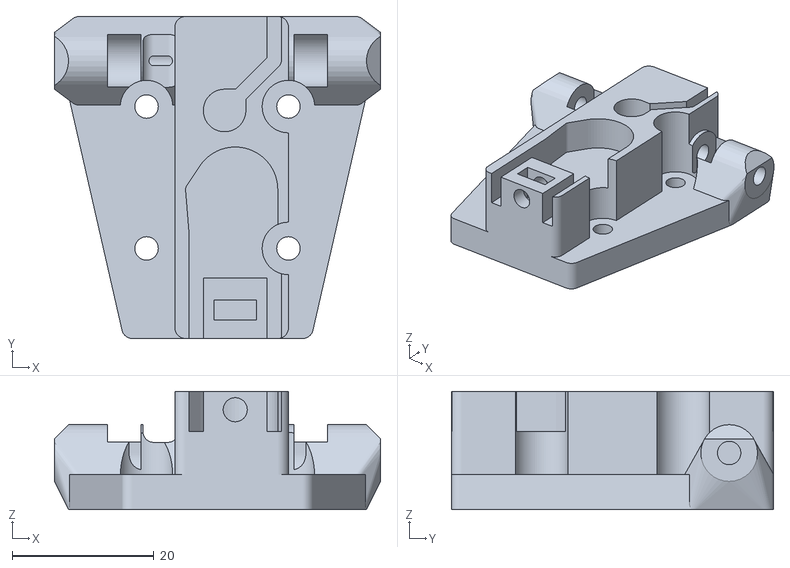
[picture p67: CAD file, 2024-10-30]
stls/carriage.stl
46.0 x 45.4 x 16.7
