beanz/typhon-scad/stls/rail_helper.stl

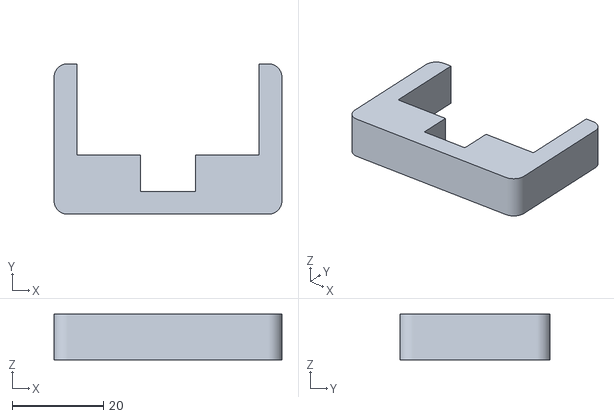
[picture p68: CAD file, 2024-10-30]
stls/rail_helper.stl
50.0 x 33.0 x 10.0
