beanz/typhon-scad/stls/top_corner.stl

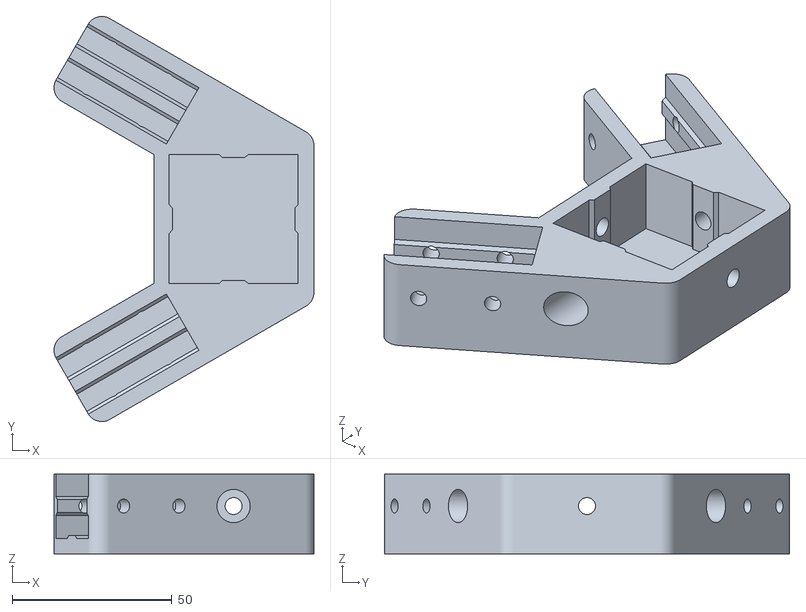
[picture p69: CAD file, 2024-10-30]
stls/top_corner.stl
81.5 x 127.0 x 25.0
