beanz/typhon-scad/stls/effector.stl

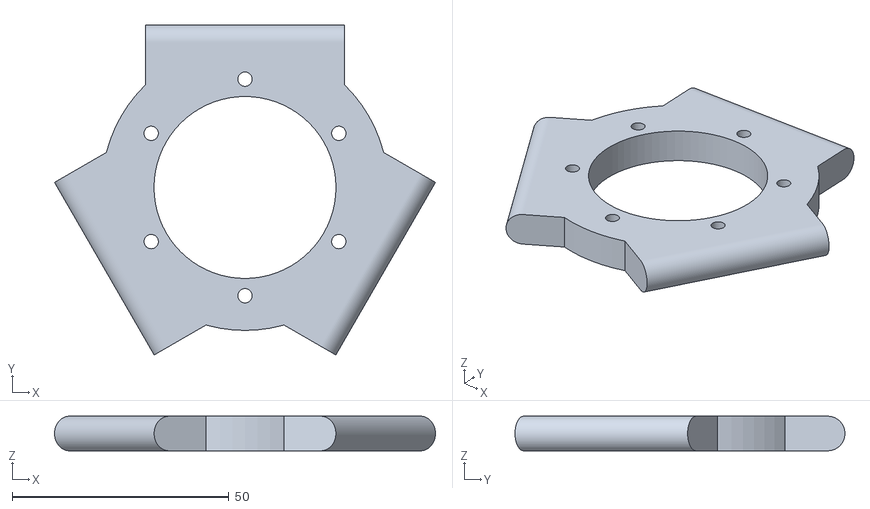
[picture p70: CAD file, 2024-10-30]
stls/effector.stl
88.0 x 76.2 x 8.00
