beanz/typhon-scad/stls/rail_guard.stl

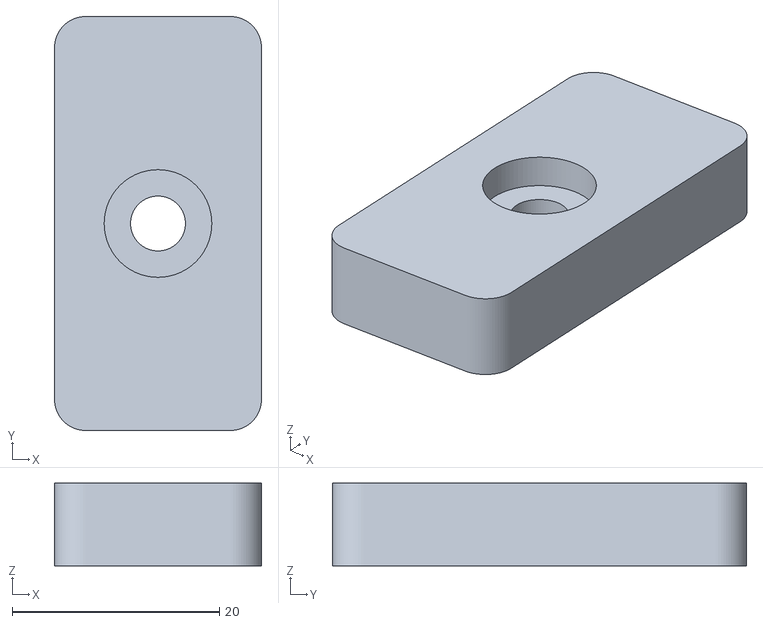
[picture p71: CAD file, 2024-10-30]
stls/rail_guard.stl
20.0 x 40.0 x 8.00
