beanz/typhon-scad/stls/bottom_motor_mount.stl

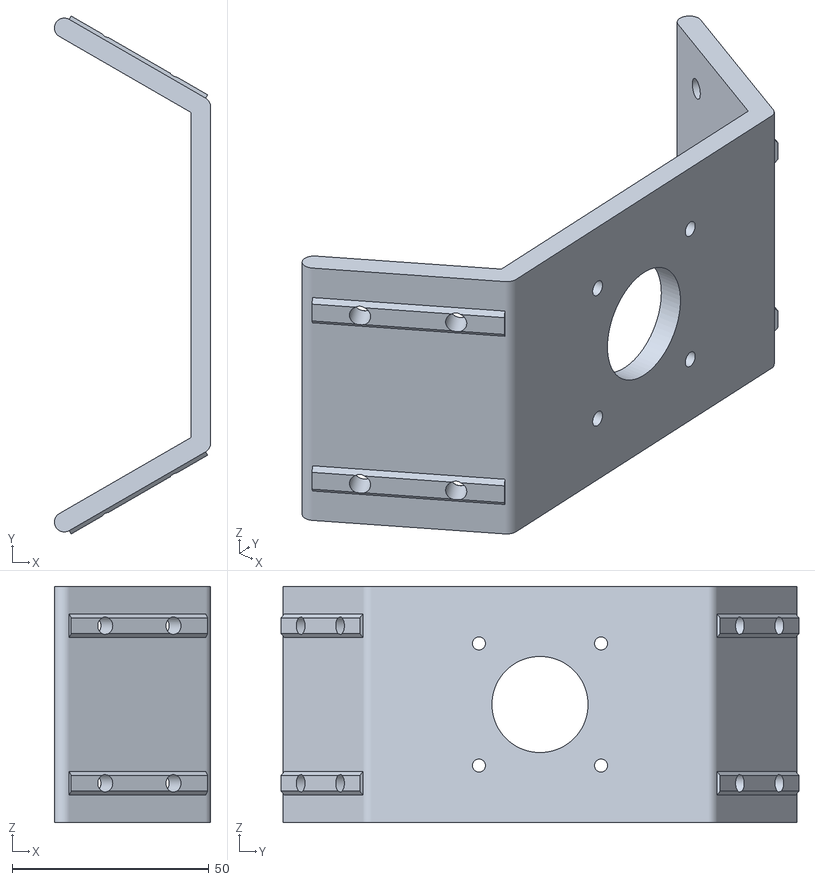
[picture p72: CAD file, 2024-10-30]
stls/bottom_motor_mount.stl
39.6 x 131.5 x 60.0
