beanz/typhon-scad/stls/bed_mount_left.stl

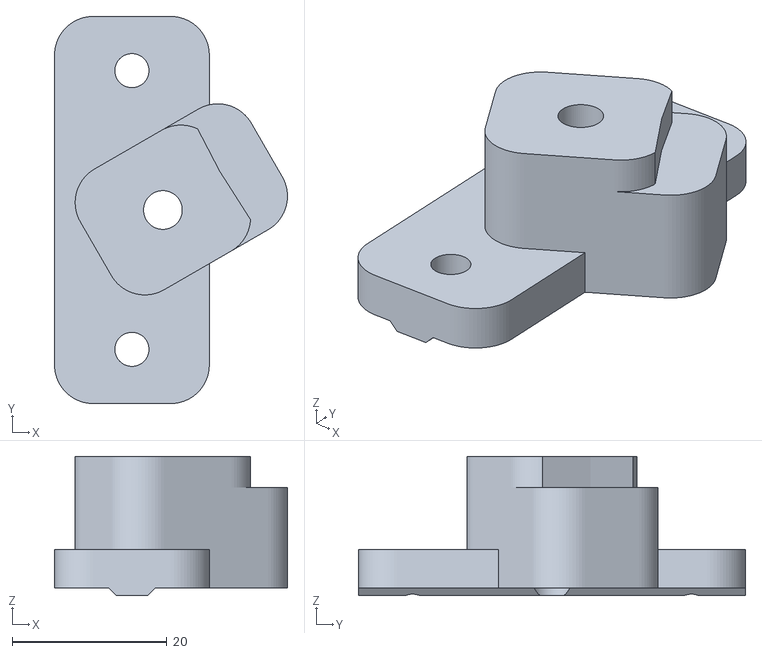
[picture p74: CAD file, 2024-10-30]
stls/bed_mount_left.stl
30.1 x 50.0 x 18.0
