beanz/typhon-scad/stls/idler.stl

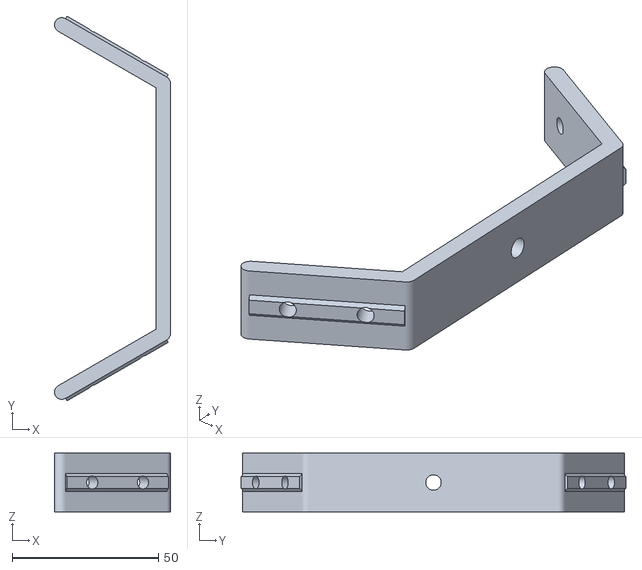
[picture p75: CAD file, 2024-10-30]
stls/idler.stl
39.6 x 131.5 x 20.0
