beanz/typhon-scad/stls/carriage_belt_tensioner.stl

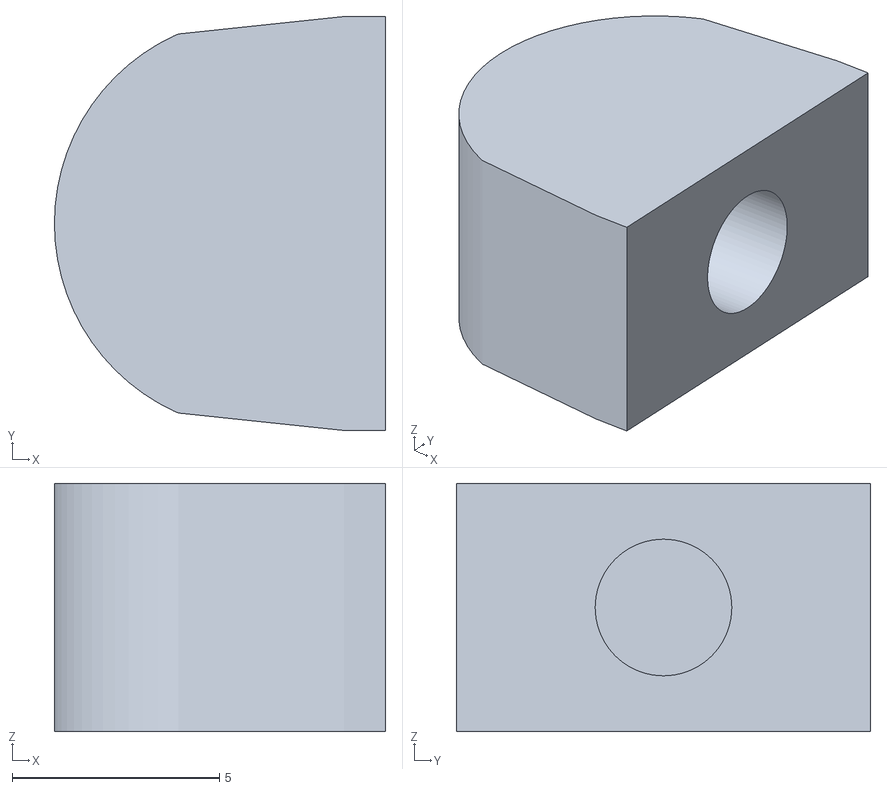
[picture p76: CAD file, 2024-10-30]
stls/carriage_belt_tensioner.stl
8.00 x 10.0 x 6.00
