beanz/typhon-scad/(list of files, cad)

Other CAD files:
stls/bed_mount_right.stl
stls/right_pcb_mount.stl
