beanz/typhon-scad/bom/arm_assembly.txt

arm_assemblies:
Vitamins:
  6 CF rod 3mm x 231mm
