beanz/typhon-scad/bom/bed_mount_left_assembly.txt

bed_mount_left_assemblies:
Vitamins:
  6 Screw M4 flanged x 10mm
  3 Screw M6 cap x 10mm
  6 Nut M4 sliding T
  3 Washer rubber M6 x 12.5mm x 1.5mm

Printed:
  3 bed_mount_left.stl
