beanz/typhon-scad/bom/bottom_corner_assembly.txt

bottom_corner_assemblies:
Vitamins:
  3 Extrusion E2020 x 300mm
 48 Screw M4 flanged x 10mm
 18 Screw M5 flanged x 16mm
 48 Nut M4 sliding T
 18 Nut M5 sliding T

Assemblies:
  3 bottom_extrusion_assemblies
  3 bottom_motor_mount_assemblies
  3 two_part_bottom_corner_assemblies
