beanz/typhon-scad/bom/bottom_extrusion_assembly.txt

bottom_extrusion_assemblies:
Vitamins:
  3 Extrusion E2020 x 300mm

Assemblies:
  3 bed_mount_left_assemblies
  3 bed_mount_right_assemblies
