beanz/typhon-scad/bom/bottom_motor_mount_assembly.txt

bottom_motor_mount_assemblies:
Vitamins:
  3 Stepper motor NEMA17 x 47mm (5x24 shaft)
  3 Pulley GT2OB 20 teeth
 12 Screw M3 cap x  8mm
  6 Screw M3 grub x  6mm
 24 Screw M4 flanged x 10mm
 24 Nut M4 sliding T
 12 Washer  M3 x 7mm x 0.5mm

Printed:
  3 bottom_motor_mount.stl
