beanz/typhon-scad/bom/duet_assembly.txt

duet_assembly:
Vitamins:
  1 Cat 5 patch cable 300mm
  1 Micro SD card
  1 Duet 2 Ethernet electronics
  4 Screw M3 cap x  6mm
  4 Screw M5 flanged x 16mm
  4 Nut M5 sliding T

Printed:
  1 left_pcb_mount.stl
  1 right_pcb_mount.stl
