beanz/typhon-scad/bom/effector_assembly.txt

effector_assembly:
Printed:
  1 effector.stl
