beanz/typhon-scad/bom/idler_assembly.txt

idler_assemblies:
Vitamins:
 12 Screw M4 flanged x 10mm
  3 Screw M5 flanged x 49mm
 12 Nut M4 sliding T
  3 Nut M5 sliding T

Printed:
  3 idler.stl
  3 idler_spacers.stl

Assemblies:
  3 idler_bearing_assemblies
