beanz/typhon-scad/bom/main_assembly.txt

main_assembly:
Printed:
  4 rail_helper.stl

Assemblies:
  1 duet_assembly
  1 effector_assembly
  1 tower_a_assembly
  1 tower_b_assembly
  1 tower_c_assembly
