beanz/typhon-scad/bom/top_corner_assembly.txt

top_corner_assemblies:
Vitamins:
  3 Extrusion E2020 x 300mm
 24 Screw M4 flanged x 10mm
  9 Screw M5 flanged x 16mm
 24 Nut M4 sliding T
  9 Nut M5 sliding T

Printed:
  3 top_corner.stl

Assemblies:
  3 idler_assemblies
