beanz/typhon-scad/bom/tower_a_assembly.txt

tower_a_assembly:
Vitamins:
  1 Belt GT2 x 6mm x 2072mm

Assemblies:
  1 bottom_corner_assembly
  1 top_corner_assembly
  1 upright_a_assembly
