beanz/typhon-scad/printme.html

# Typhon-scad

Cerberus-revised for MGN rails

Main Assembly

## Table of Contents

1. Parts list
2. Duet Assembly
3. Effector Assembly
4. Idler Bearing Assembly
5. Idler Assembly
6. Top Corner Assembly
7. Bottom Motor Mount Assembly
8. Bed Mount Right Assembly
9. Bed Mount Left Assembly
10. Bottom Extrusion Assembly
11. Bottom Corner Bottom Assembly
12. Two Part Bottom Corner Assembly
13. Bottom Corner Assembly
14. Arm Assembly
15. Carriage Assembly
16. Rail Guard Assembly
17. Upright C Assembly
18. Tower C Assembly
19. Upright B Assembly
20. Tower B Assembly
21. Upright A Assembly
22. Tower A Assembly
23. Main Assembly

## Parts list

Duet | Effector | 3 x Idler Bearing | 3 x Idler | 3 x Top Corner | 3 x Bottom Motor Mount | 3 x Bed Mount Right | 3 x Bed Mount Left | 3 x Bottom Extrusion | 3 x Bottom Corner Bottom | 3 x Two Part Bottom Corner | 3 x Bottom Corner | 3 x Arm | 3 x Carriage | 3 x Rail Guard | Upright C | Tower C | Upright B | Tower B | Upright A | Tower A | Main | TOTALS
| | | | | | | | | | | | | | | | | | | | | | | Vitamins
. | . | 6 | . | . | . | . | . | . | . | . | . | . | . | . | . | . | . | . | . | . | . | 6 | Ball bearing F625ZZ 5mm x 16mm x 5mm
. | . | . | . | . | . | . | . | . | . | . | . | . | . | . | . | 1 | . | . | . | . | . | 1 | Belt GT2 x 6mm x 2072mm
. | . | . | . | . | . | . | . | . | . | . | . | . | . | . | . | . | . | 1 | . | . | . | 1 | Belt GT2 x 6mm x 2072mm
. | . | . | . | . | . | . | . | . | . | . | . | . | . | . | . | . | . | . | . | 1 | . | 1 | Belt GT2 x 6mm x 2072mm
. | . | . | . | . | . | . | . | . | . | . | . | 6 | . | . | . | . | . | . | . | . | . | 6 | CF rod 3mm x 231mm
1 | . | . | . | . | . | . | . | . | . | . | . | . | . | . | . | . | . | . | . | . | . | 1 | Cat 5 patch cable 300mm
1 | . | . | . | . | . | . | . | . | . | . | . | . | . | . | . | . | . | . | . | . | . | 1 | Duet 2 Ethernet electronics
. | . | . | . | 3 | . | . | . | 3 | . | . | 3 | . | . | . | . | . | . | . | . | . | . | 9 | Extrusion E2020 x 300mm
. | . | . | . | . | . | . | . | . | . | . | . | . | . | . | 1 | . | 1 | . | 1 | . | . | 3 | Extrusion E4040 x 1000mm
. | . | . | . | . | . | . | . | . | 24 | . | . | . | . | . | . | . | . | . | . | . | . | 24 | Heatfit insert M3 x 4mm
. | . | . | . | . | . | . | . | . | . | . | . | . | . | . | 1 | . | 1 | . | 1 | . | . | 3 | Linear rail MGN12 x 800mm
. | . | . | . | . | . | . | . | . | . | . | . | . | 3 | . | . | . | . | . | . | . | . | 3 | Linear rail carriage MGN12H
1 | . | . | . | . | . | . | . | . | . | . | . | . | . | . | . | . | . | . | . | . | . | 1 | Micro SD card
. | . | . | . | . | . | . | . | . | . | . | . | . | 3 | . | . | . | . | . | . | . | . | 3 | Nut M3 x 2.4mm
. | . | . | . | . | . | . | . | . | . | . | . | . | 6 | . | . | . | . | . | . | . | . | 6 | Nut M3 x 2.4mm nyloc
. | . | . | 12 | 24 | 24 | 6 | 6 | . | . | . | 48 | . | . | . | . | . | . | . | . | . | . | 120 | Nut M4 sliding T
4 | . | . | 3 | 9 | . | . | . | . | . | . | 18 | . | . | 3 | . | . | . | . | . | . | . | 37 | Nut M5 sliding T
. | . | . | . | . | 3 | . | . | . | . | . | . | . | . | . | . | . | . | . | . | . | . | 3 | Pulley GT2OB 20 teeth
4 | . | . | . | . | . | . | . | . | . | . | . | . | . | . | . | . | . | . | . | . | . | 4 | Screw M3 cap x 6mm
. | . | . | . | . | 12 | . | . | . | . | . | . | . | . | . | . | . | . | . | . | . | . | 12 | Screw M3 cap x 8mm
. | . | . | . | . | . | . | . | . | . | 24 | . | . | 12 | . | . | . | . | . | . | . | . | 36 | Screw M3 cap x 10mm
. | . | . | . | . | . | . | . | . | . | . | . | . | . | . | 18 | . | 18 | . | 18 | . | . | 54 | Screw M3 cap x 16mm
. | . | . | . | . | . | . | . | . | . | . | . | . | 9 | . | . | . | . | . | . | . | . | 9 | Screw M3 cap x 20mm
. | . | . | . | . | 6 | . | . | . | . | . | . | . | . | . | . | . | . | . | . | . | . | 6 | Screw M3 grub x 6mm
. | . | . | 12 | 24 | 24 | 6 | 6 | . | . | . | 48 | . | . | . | . | . | . | . | . | . | . | 120 | Screw M4 flanged x 10mm
4 | . | . | . | 9 | . | . | . | . | . | . | 18 | . | . | 3 | . | . | . | . | . | . | . | 34 | Screw M5 flanged x 16mm
. | . | . | 3 | . | . | . | . | . | . | . | . | . | . | . | . | . | . | . | . | . | . | 3 | Screw M5 flanged x 49mm
. | . | . | . | . | . | 3 | 3 | . | . | . | . | . | . | . | . | . | . | . | . | . | . | 6 | Screw M6 cap x 10mm
. | . | . | . | . | 3 | . | . | . | . | . | . | . | . | . | . | . | . | . | . | . | . | 3 | Stepper motor NEMA17 x 47mm (5x24 shaft)
. | . | . | . | . | 12 | . | . | . | . | . | . | . | 24 | . | . | . | . | . | . | . | . | 36 | Washer M3 x 7mm x 0.5mm
. | . | 6 | . | . | . | . | . | . | . | . | . | . | . | . | . | . | . | . | . | . | . | 6 | Washer M5 x 10mm x 1mm
. | . | . | . | . | . | 3 | 3 | . | . | . | . | . | . | . | . | . | . | . | . | . | . | 6 | Washer rubber M6 x 12.5mm x 1.5mm
15 | . | 12 | 30 | 69 | 84 | 18 | 18 | 3 | 24 | 24 | 135 | 6 | 57 | 6 | 20 | 1 | 20 | 1 | 20 | 1 | . | 564 | Total vitamins count
| | | | | | | | | | | | | | | | | | | | | | | 3D printed parts
. | . | . | . | . | . | . | 3 | . | . | . | . | . | . | . | . | . | . | . | . | . | . | 3 | bed_mount_left.stl
. | . | . | . | . | . | 3 | . | . | . | . | . | . | . | . | . | . | . | . | . | . | . | 3 | bed_mount_right.stl
. | . | . | . | . | . | . | . | . | 3 | . | . | . | . | . | . | . | . | . | . | . | . | 3 | bottom_corner_bottom.stl
. | . | . | . | . | . | . | . | . | . | 3 | . | . | . | . | . | . | . | . | . | . | . | 3 | bottom_corner_top.stl
. | . | . | . | . | 3 | . | . | . | . | . | . | . | . | . | . | . | . | . | . | . | . | 3 | bottom_motor_mount.stl
. | . | . | . | . | . | . | . | . | . | . | . | . | 3 | . | . | . | . | . | . | . | . | 3 | carriage.stl
. | . | . | . | . | . | . | . | . | . | . | . | . | 3 | . | . | . | . | . | . | . | . | 3 | carriage_belt_tensioner.stl
. | 1 | . | . | . | . | . | . | . | . | . | . | . | . | . | . | . | . | . | . | . | . | 1 | effector.stl
. | . | . | 3 | . | . | . | . | . | . | . | . | . | . | . | . | . | . | . | . | . | . | 3 | idler.stl
. | . | . | 3 | . | . | . | . | . | . | . | . | . | . | . | . | . | . | . | . | . | . | 3 | idler_spacers.stl
1 | . | . | . | . | . | . | . | . | . | . | . | . | . | . | . | . | . | . | . | . | . | 1 | left_pcb_mount.stl
. | . | . | . | . | . | . | . | . | . | . | . | . | . | 3 | . | . | . | . | . | . | . | 3 | rail_guard.stl
. | . | . | . | . | . | . | . | . | . | . | . | . | . | . | . | . | . | . | . | . | 4 | 4 | rail_helper.stl
1 | . | . | . | . | . | . | . | . | . | . | . | . | . | . | . | . | . | . | . | . | . | 1 | right_pcb_mount.stl
. | . | . | . | 3 | . | . | . | . | . | . | . | . | . | . | . | . | . | . | . | . | . | 3 | top_corner.stl
2 | 1 | . | 6 | 3 | 3 | 3 | 3 | . | 3 | 3 | . | . | 6 | 3 | . | . | . | . | . | . | 4 | 40 | Total 3D printed parts count

## Duet Assembly

### Vitamins

Qty | Description
1 | Cat 5 patch cable 300mm
1 | Duet 2 Ethernet electronics
1 | Micro SD card
4 | Nut M5 sliding T
4 | Screw M3 cap x 6mm
4 | Screw M5 flanged x 16mm

### 3D Printed parts

1 x left_pcb_mount.stl | 1 x right_pcb_mount.stl
left_pcb_mount.stl | right_pcb_mount.stl

### Assembly instructions

duet_assembly

duet_assembled

## Effector Assembly

### 3D Printed parts

1 x effector.stl

effector.stl

### Assembly instructions

effector_assembly

effector_assembled

## 3 x Idler Bearing Assembly

### Vitamins

Qty | Description
6 | Ball bearing F625ZZ 5mm x 16mm x 5mm
6 | Washer M5 x 10mm x 1mm

### Assembly instructions

idler_bearing_assembly

idler_bearing_assembled

## 3 x Idler Assembly

### Vitamins

Qty | Description
12 | Nut M4 sliding T
3 | Nut M5 sliding T
12 | Screw M4 flanged x 10mm
3 | Screw M5 flanged x 49mm

### 3D Printed parts

3 x idler.stl | 3 x idler_spacers.stl
idler.stl | idler_spacers.stl

### Sub-assemblies

3 x idler_bearing_assembly

idler_bearing_assembled

### Assembly instructions

idler_assembly

idler_assembled

## 3 x Top Corner Assembly

### Vitamins

Qty | Description
3 | Extrusion E2020 x 300mm
24 | Nut M4 sliding T
9 | Nut M5 sliding T
24 | Screw M4 flanged x 10mm
9 | Screw M5 flanged x 16mm

### 3D Printed parts

3 x top_corner.stl

top_corner.stl

### Sub-assemblies

3 x idler_assembly

idler_assembled

### Assembly instructions

top_corner_assembly

top_corner_assembled

## 3 x Bottom Motor Mount Assembly

### Vitamins

Qty | Description
24 | Nut M4 sliding T
3 | Pulley GT2OB 20 teeth
12 | Screw M3 cap x 8mm
6 | Screw M3 grub x 6mm
24 | Screw M4 flanged x 10mm
3 | Stepper motor NEMA17 x 47mm (5x24 shaft)
12 | Washer M3 x 7mm x 0.5mm

### 3D Printed parts

3 x bottom_motor_mount.stl

bottom_motor_mount.stl

### Assembly instructions

bottom_motor_mount_assembly

bottom_motor_mount_assembled

## 3 x Bed Mount Right Assembly

### Vitamins

Qty | Description
6 | Nut M4 sliding T
6 | Screw M4 flanged x 10mm
3 | Screw M6 cap x 10mm
3 | Washer rubber M6 x 12.5mm x 1.5mm

### 3D Printed parts

3 x bed_mount_right.stl

bed_mount_right.stl

### Assembly instructions

bed_mount_right_assembly

bed_mount_right_assembled

## 3 x Bed Mount Left Assembly

### Vitamins

Qty | Description
6 | Nut M4 sliding T
6 | Screw M4 flanged x 10mm
3 | Screw M6 cap x 10mm
3 | Washer rubber M6 x 12.5mm x 1.5mm

### 3D Printed parts

3 x bed_mount_left.stl

bed_mount_left.stl

### Assembly instructions

bed_mount_left_assembly

bed_mount_left_assembled

## 3 x Bottom Extrusion Assembly

### Vitamins

Qty | Description
3 | Extrusion E2020 x 300mm

### Sub-assemblies

3 x bed_mount_left_assembly | 3 x bed_mount_right_assembly
bed_mount_left_assembled | bed_mount_right_assembled

### Assembly instructions

bottom_extrusion_assembly

bottom_extrusion_assembled

## 3 x Bottom Corner Bottom Assembly

### Vitamins

Qty | Description
24 | Heatfit insert M3 x 4mm

### 3D Printed parts

3 x bottom_corner_bottom.stl

bottom_corner_bottom.stl

### Assembly instructions

bottom_corner_bottom_assembly

bottom_corner_bottom_assembled

## 3 x Two Part Bottom Corner Assembly

### Vitamins

Qty | Description
24 | Screw M3 cap x 10mm

### 3D Printed parts

3 x bottom_corner_top.stl

bottom_corner_top.stl

### Sub-assemblies

3 x bottom_corner_bottom_assembly

bottom_corner_bottom_assembled

### Assembly instructions

two_part_bottom_corner_assembly

two_part_bottom_corner_assembled

## 3 x Bottom Corner Assembly

### Vitamins

Qty | Description
3 | Extrusion E2020 x 300mm
48 | Nut M4 sliding T
18 | Nut M5 sliding T
48 | Screw M4 flanged x 10mm
18 | Screw M5 flanged x 16mm

### Sub-assemblies

3 x bottom_extrusion_assembly | 3 x bottom_motor_mount_assembly | 3 x two_part_bottom_corner_assembly
bottom_extrusion_assembled | bottom_motor_mount_assembled | two_part_bottom_corner_assembled

### Assembly instructions

bottom_corner_assembly

bottom_corner_assembled

## 3 x Arm Assembly

### Vitamins

Qty | Description
6 | CF rod 3mm x 231mm

### Assembly instructions

arm_assembly

arm_assembled

## 3 x Carriage Assembly

### Vitamins

Qty | Description
3 | Linear rail carriage MGN12H
3 | Nut M3 x 2.4mm
6 | Nut M3 x 2.4mm nyloc
12 | Screw M3 cap x 10mm
9 | Screw M3 cap x 20mm
24 | Washer M3 x 7mm x 0.5mm

### 3D Printed parts

3 x carriage.stl | 3 x carriage_belt_tensioner.stl
carriage.stl | carriage_belt_tensioner.stl

### Sub-assemblies

3 x arm_assembly

arm_assembled

### Assembly instructions

carriage_assembly

carriage_assembled

## 3 x Rail Guard Assembly

### Vitamins

Qty | Description
3 | Nut M5 sliding T
3 | Screw M5 flanged x 16mm

### 3D Printed parts

3 x rail_guard.stl

rail_guard.stl

### Assembly instructions

rail_guard_assembly

rail_guard_assembled

## Upright C Assembly

### Vitamins

Qty | Description
1 | Extrusion E4040 x 1000mm
1 | Linear rail MGN12 x 800mm
18 | Screw M3 cap x 16mm

### Sub-assemblies

1 x carriage_assembly | 1 x rail_guard_assembly
carriage_assembled | rail_guard_assembled

### Assembly instructions

upright_c_assembly

upright_c_assembled

## Tower C Assembly

### Vitamins

Qty | Description
1 | Belt GT2 x 6mm x 2072mm

### Sub-assemblies

1 x bottom_corner_assembly | 1 x top_corner_assembly | 1 x upright_c_assembly
bottom_corner_assembled | top_corner_assembled | upright_c_assembled

### Assembly instructions

tower_c_assembly

tower_c_assembled

## Upright B Assembly

### Vitamins

Qty | Description
1 | Extrusion E4040 x 1000mm
1 | Linear rail MGN12 x 800mm
18 | Screw M3 cap x 16mm

### Sub-assemblies

1 x carriage_assembly | 1 x rail_guard_assembly
carriage_assembled | rail_guard_assembled

### Assembly instructions

upright_b_assembly

upright_b_assembled

## Tower B Assembly

### Vitamins

Qty | Description
1 | Belt GT2 x 6mm x 2072mm

### Sub-assemblies

1 x bottom_corner_assembly | 1 x top_corner_assembly | 1 x upright_b_assembly
bottom_corner_assembled | top_corner_assembled | upright_b_assembled

### Assembly instructions

tower_b_assembly

tower_b_assembled

## Upright A Assembly

### Vitamins

Qty | Description
1 | Extrusion E4040 x 1000mm
1 | Linear rail MGN12 x 800mm
18 | Screw M3 cap x 16mm

### Sub-assemblies

1 x carriage_assembly | 1 x rail_guard_assembly
carriage_assembled | rail_guard_assembled

### Assembly instructions

upright_a_assembly

upright_a_assembled

## Tower A Assembly

### Vitamins

Qty | Description
1 | Belt GT2 x 6mm x 2072mm

### Sub-assemblies

1 x bottom_corner_assembly | 1 x top_corner_assembly | 1 x upright_a_assembly
bottom_corner_assembled | top_corner_assembled | upright_a_assembled

### Assembly instructions

tower_a_assembly

tower_a_assembled

## Main Assembly

### 3D Printed parts

4 x rail_helper.stl

rail_helper.stl

### Sub-assemblies

1 x duet_assembly | 1 x effector_assembly | 1 x tower_a_assembly
duet_assembled | effector_assembled | tower_a_assembled

1 x tower_b_assembly | 1 x tower_c_assembly
tower_b_assembled | tower_c_assembled

### Assembly instructions

main_assembly

Insert PSU

main_assembled
