beanz/typhon-scad/assemblies/arm_assembled.png

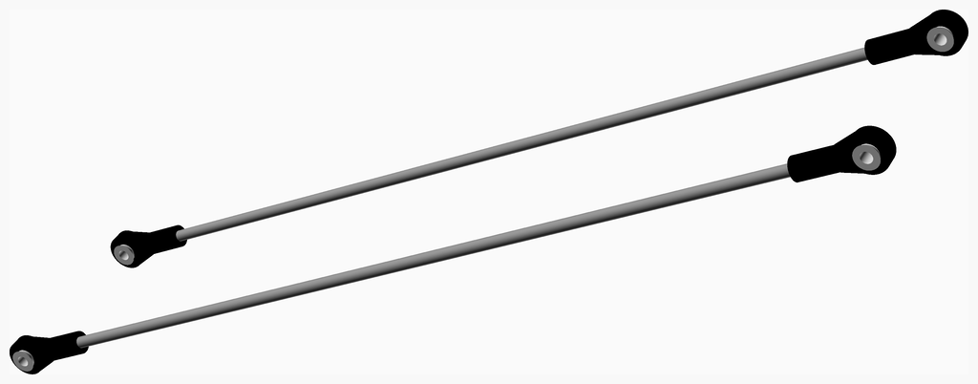
assemblies/arm_assembled.png
