beanz/typhon-scad/assemblies/bed_mount_left_assembled.png

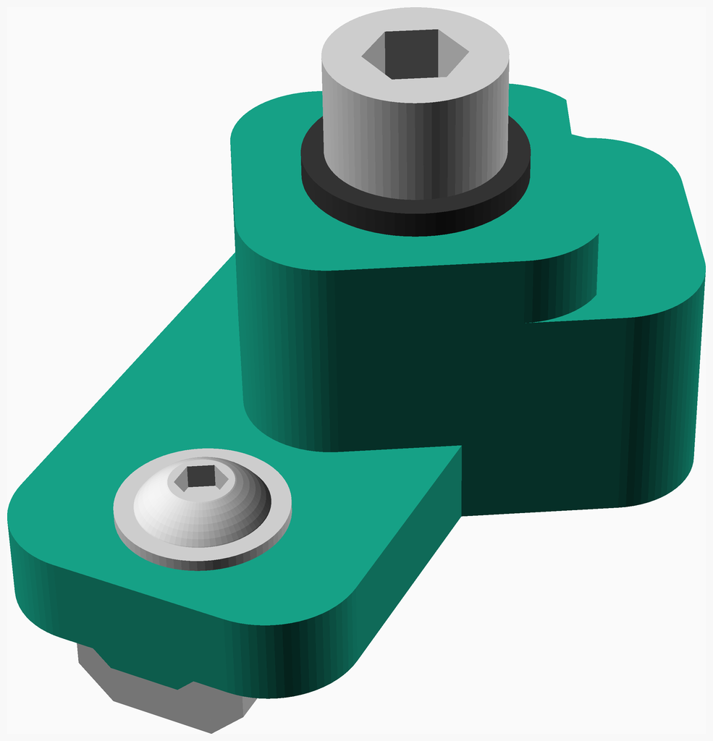
assemblies/bed_mount_left_assembled.png
