beanz/typhon-scad/assemblies/bed_mount_left_assembly.png

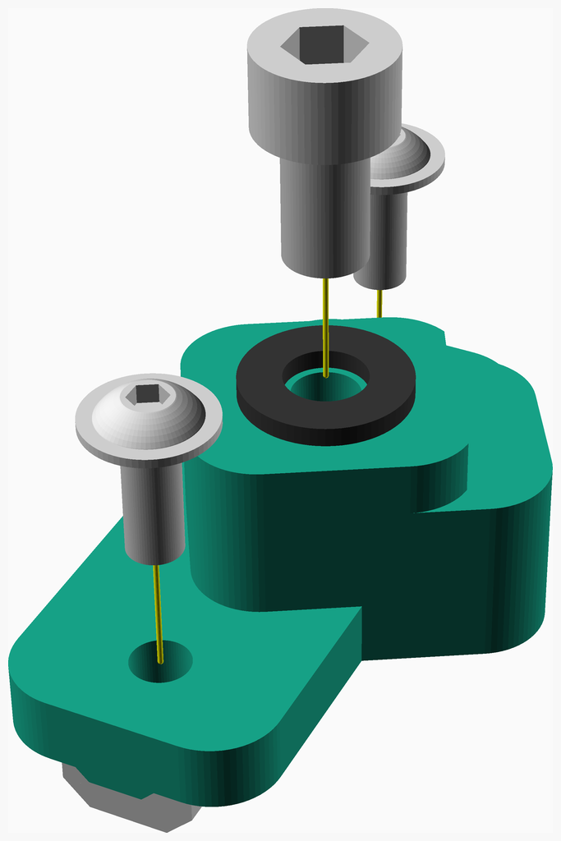
assemblies/bed_mount_left_assembly.png
