beanz/typhon-scad/assemblies/bed_mount_right_assembled.png

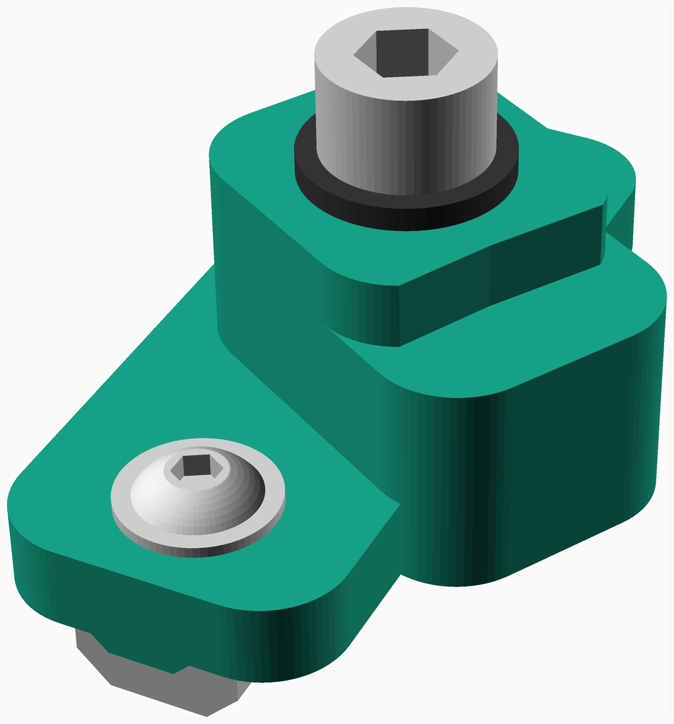
assemblies/bed_mount_right_assembled.png
