beanz/typhon-scad/assemblies/bed_mount_right_assembly.png

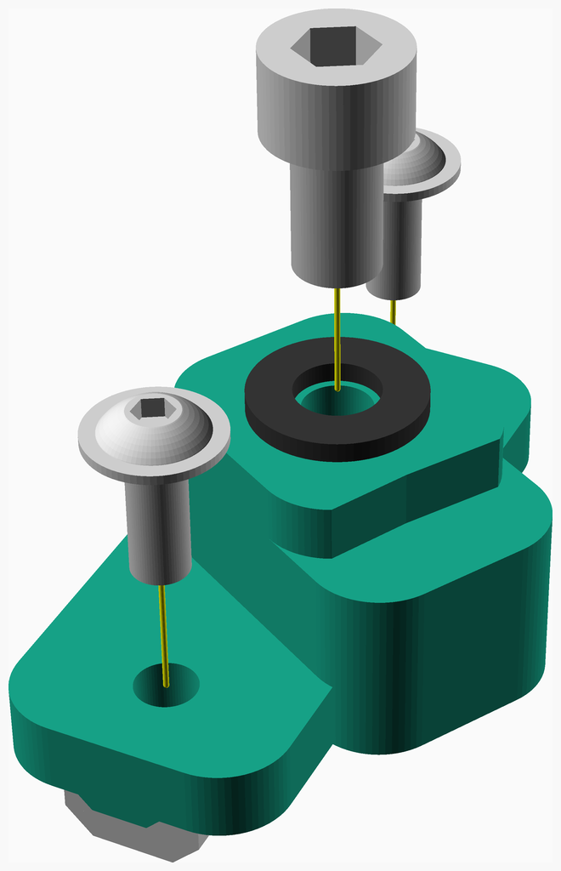
assemblies/bed_mount_right_assembly.png
