beanz/typhon-scad/assemblies/bottom_corner_bottom_assembly_tn.png

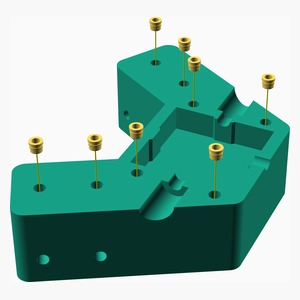
assemblies/bottom_corner_bottom_assembly_tn.png
