beanz/typhon-scad/assemblies/bottom_extrusion_assembled.png

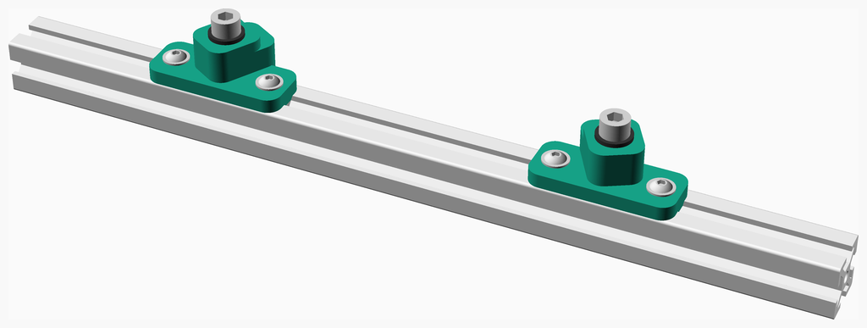
assemblies/bottom_extrusion_assembled.png
