beanz/typhon-scad/assemblies/bottom_motor_mount_assembly_tn.png

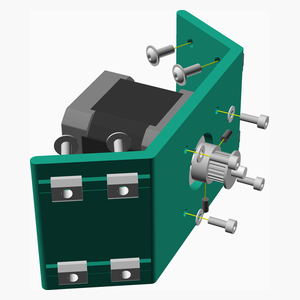
assemblies/bottom_motor_mount_assembly_tn.png
