beanz/typhon-scad/assemblies/carriage_assembled.png

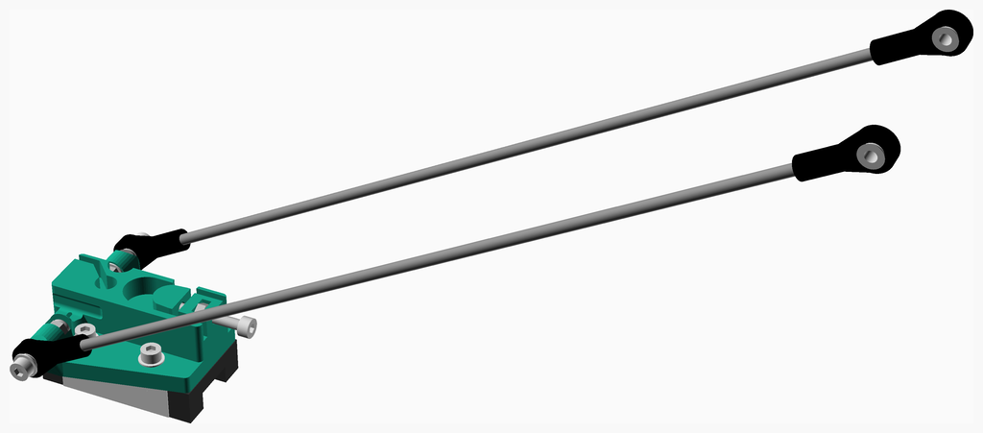
assemblies/carriage_assembled.png
