beanz/typhon-scad/assemblies/carriage_assembly.png

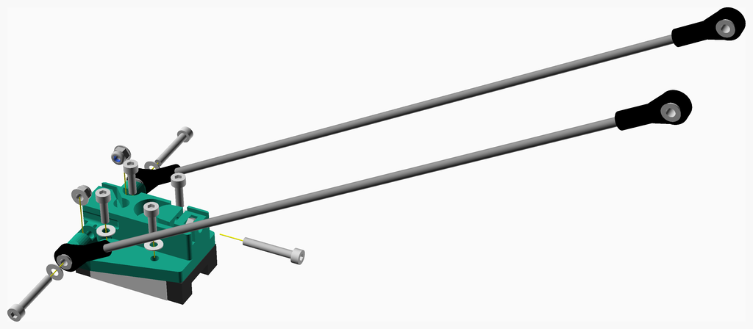
assemblies/carriage_assembly.png
