beanz/typhon-scad/assemblies/idler_assembly_tn.png

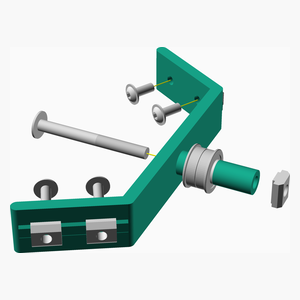
assemblies/idler_assembly_tn.png
