beanz/typhon-scad/assemblies/idler_bearing_assembly.png

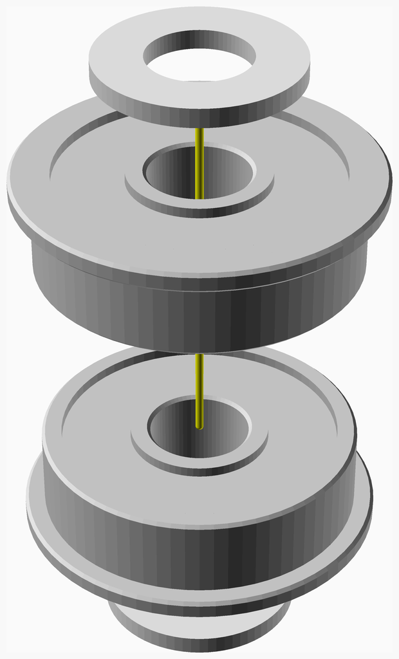
assemblies/idler_bearing_assembly.png
