beanz/typhon-scad/assemblies/rail_guard_assembled.png

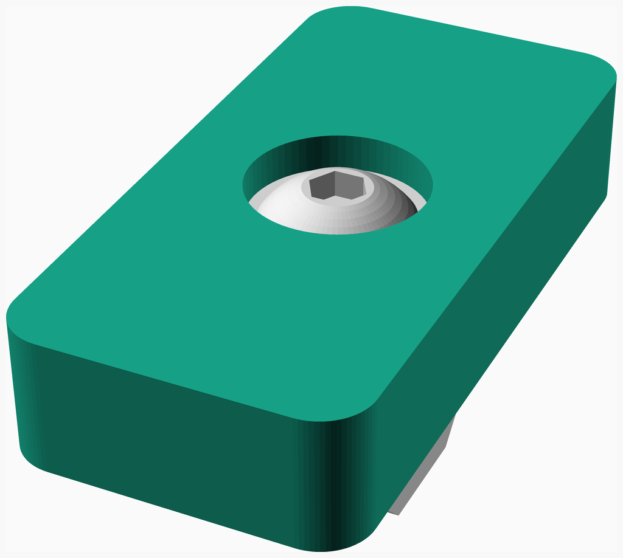
assemblies/rail_guard_assembled.png
