beanz/typhon-scad/assemblies/rail_guard_assembly.png

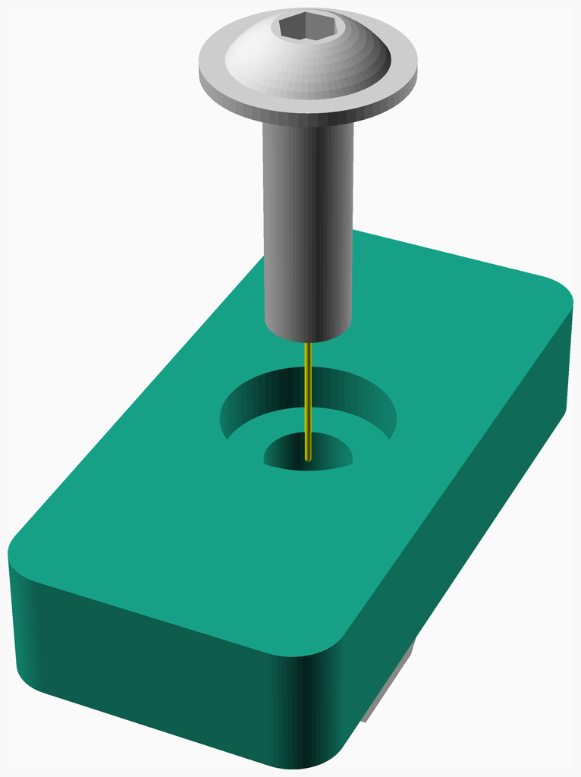
assemblies/rail_guard_assembly.png
