beanz/typhon-scad/assemblies/two_part_bottom_corner_assembly_tn.png

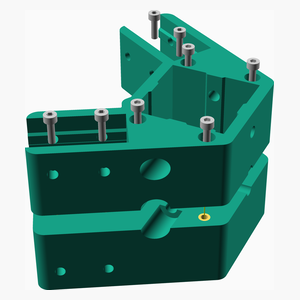
assemblies/two_part_bottom_corner_assembly_tn.png
