beanz/typhon-scad/assemblies/upright_a_assembled.png

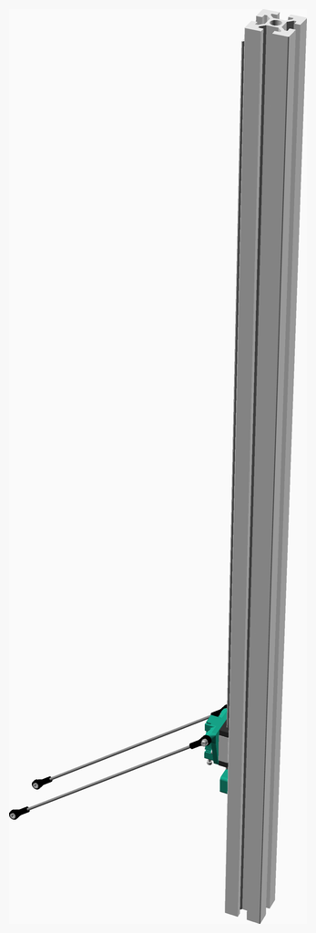
assemblies/upright_a_assembled.png
