beanz/typhon-scad/assemblies/upright_b_assembled.png

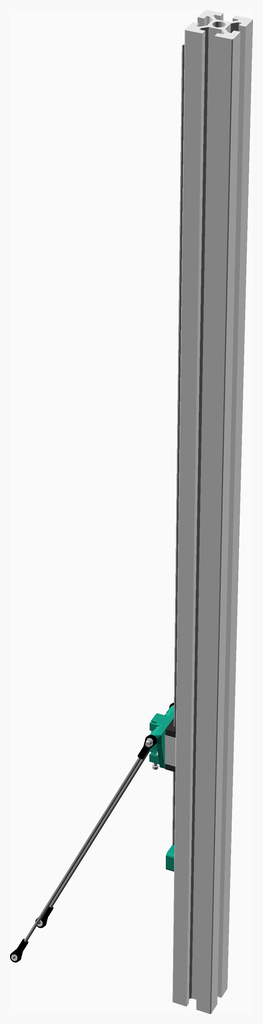
assemblies/upright_b_assembled.png
