beanz/typhon-scad/assemblies/upright_c_assembled.png

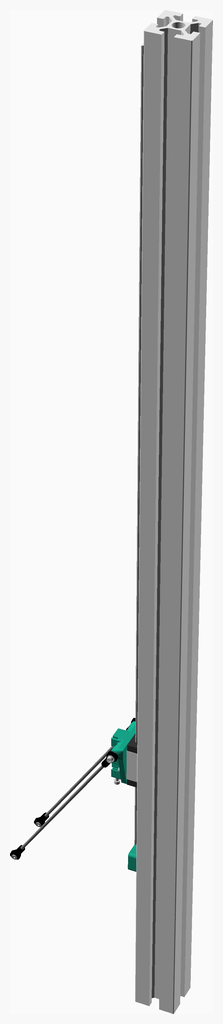
assemblies/upright_c_assembled.png
