beanz/typhon-scad/(commit log)

2024-09-30 rough frame
    [bottom.scad, carriage.scad, conf.scad, main.scad, top.scad, vitamins.scad]
2024-10-01 feat: pulleys and belts (wip)
    [belts.scad, bottom.scad, carriage.scad, conf.scad, main.scad, top.scad]
2024-10-02 chore: improve belts and begin belt grip/tensioning
    [belts.scad, carriage.scad, main.scad]
2024-10-03 chore: more carriage tensioner design
    [carriage.scad]
2024-10-05 chore: split tower assemblies to model kinematics (wip)
    [carriage.scad, conf.scad, effector.scad, main.scad, vitamins.scad]
2024-10-26 chore: extrusion alignment guides
    [bottom.scad, conf.scad, top.scad]
2024-10-26 wip: spectra drive option
    [bottom.scad, conf.scad, main.scad, top.scad]
2024-10-27 chore: add extrusion aligner to idler part
    [top.scad]
2024-10-27 chore: option to split bottom corner print
    [bottom.scad, conf.scad]
2024-10-27 chore: fix for my 4040 extrusion
    [conf.scad]
2024-10-27 chore: add rail guard
    [main.scad]
2024-10-27 chore: add rail alignment tool
    [main.scad]
2024-10-27 chore: round extrusion length to 300mm
    [conf.scad]
2024-10-27 chore: fix insert hole size
    [bottom.scad, conf.scad]
2024-10-27 chore: include clearance in extrusion cut
    [bottom.scad, conf.scad]
2024-10-27 chore: add duet mount
    [main.scad]
2024-10-29 chore: correct bed mount screws
    [bottom.scad]
2024-10-29 chore: add extrusion aligner to motor mount
    [bottom.scad]
2024-10-29 chore: consistent screws
    [bottom.scad, conf.scad, main.scad, top.scad]
2024-10-29 chore: add extrusion aligner to pcb mount
    [main.scad]
2024-10-30 chore: add idler spacers
    [top.scad]
2024-10-30 chore: add rail screws (meant for every other hole)
    [main.scad]
2024-10-30 chore: fix M5 t nut
    [main.scad, top.scad]
2024-10-30 docs: update generated files
    [bed_mount_left.stl, bed_mount_right.stl, bom.csv, bottom_corner.stl, bottom_motor_mount.stl, carriage.stl, idler.stl, top_corner.stl]
2024-10-30 update generated
    [bom.csv]
